CarnivalBen/golden-key/concept/circuit-board.JPG

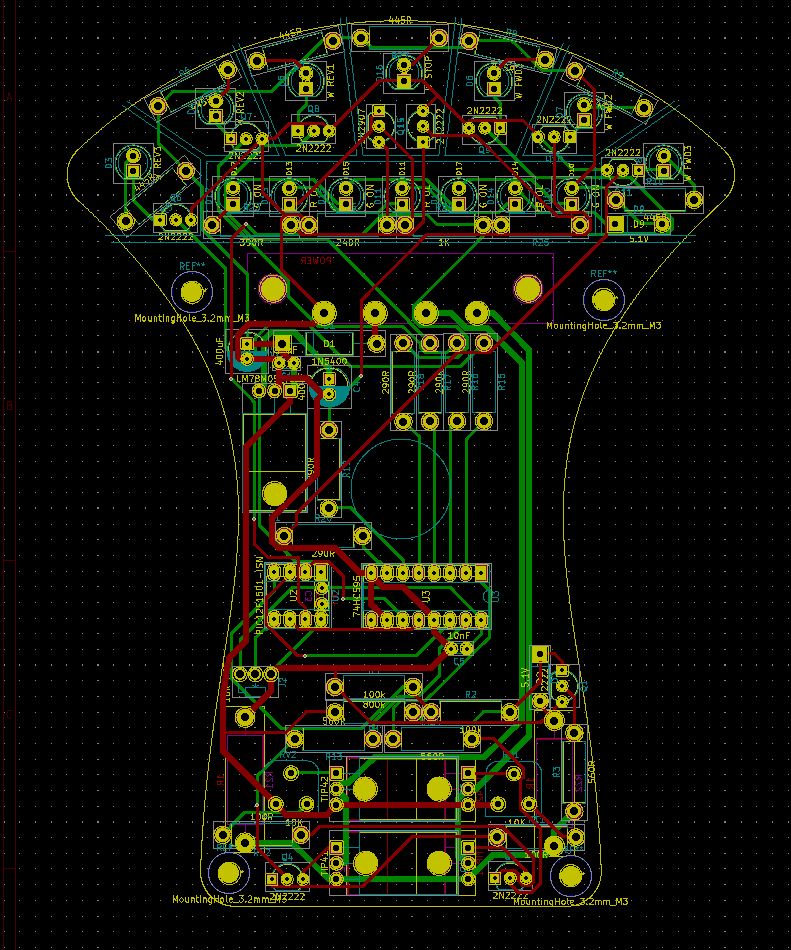
concept/circuit-board.JPG
