CarnivalBen/golden-key/concept/Golden Key Layout.JPG

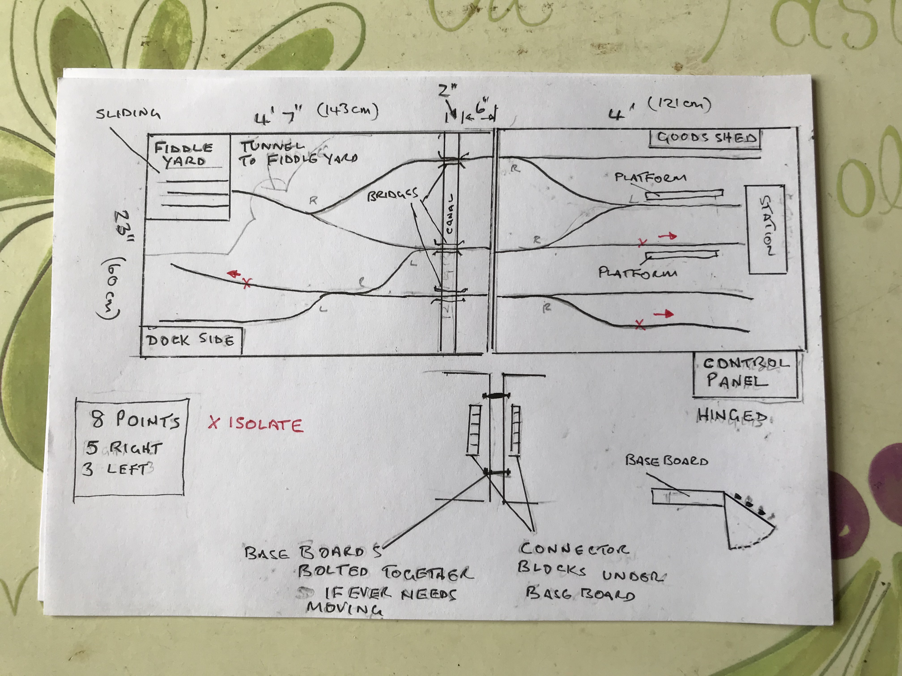
concept/Golden Key Layout.JPG
