CarnivalBen/golden-key/concept/Track Speed Adjust Graph 2.xlsx

Sheet: Sheet1
0 | 31 | 0x1F, | 8
1 | 31 | 0x1F,
2 | 31 | 0x1F,
3 | 31 | 0x1F,
4 | 31 | 0x1F,
5 | 31 | 0x1F,
6 | 31 | 0x1F,
7 | 31 | 0x1F,
8 | 30 | 0x1E,
9 | 30 | 0x1E,
10 | 30 | 0x1E,
11 | 30 | 0x1E,
12 | 30 | 0x1E,
13 | 30 | 0x1E,
14 | 30 | 0x1E,
15 | 30 | 0x1E,
16 | 29 | 0x1D,
17 | 29 | 0x1D,
18 | 29 | 0x1D,
19 | 29 | 0x1D,
20 | 29 | 0x1D,
21 | 29 | 0x1D,
22 | 29 | 0x1D,
23 | 29 | 0x1D,
24 | 28 | 0x1C,
25 | 28 | 0x1C,
26 | 28 | 0x1C,
27 | 28 | 0x1C,
28 | 28 | 0x1C,
29 | 28 | 0x1C,
30 | 28 | 0x1C,
31 | 28 | 0x1C,
32 | 27 | 0x1B,
33 | 27 | 0x1B,
34 | 27 | 0x1B,
35 | 27 | 0x1B,
36 | 27 | 0x1B,
37 | 27 | 0x1B,
38 | 27 | 0x1B,
39 | 27 | 0x1B,
40 | 26 | 0x1A,
41 | 26 | 0x1A,
42 | 26 | 0x1A,
43 | 26 | 0x1A,
44 | 26 | 0x1A,
45 | 26 | 0x1A,
46 | 26 | 0x1A,
47 | 26 | 0x1A,
48 | 25 | 0x19,
49 | 25 | 0x19,
50 | 25 | 0x19,
51 | 25 | 0x19,
52 | 25 | 0x19,
53 | 25 | 0x19,
54 | 25 | 0x19,
55 | 25 | 0x19,
56 | 24 | 0x18,
57 | 24 | 0x18,
58 | 24 | 0x18,
59 | 24 | 0x18,
60 | 24 | 0x18,
61 | 24 | 0x18,
62 | 24 | 0x18,
63 | 24 | 0x18,
64 | 23 | 0x17,
65 | 23 | 0x17,
66 | 23 | 0x17,
67 | 23 | 0x17,
68 | 23 | 0x17,
69 | 23 | 0x17,
70 | 23 | 0x17,
71 | 23 | 0x17,
72 | 22 | 0x16,
73 | 22 | 0x16,
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
