CarnivalBen/golden-key/concept/LED Count.xlsx

DK-1 | DK-1G | 4 | DK-1R | 4
MLE-1 | MLE-1G | 4 | MLE-1R | 4
MLE-2 | MLE-2G | 4 | MLE-2R | 3
SD-1 | SD-1G | 2 | SD-1R | 2
SD-2 | SD-2G | 2 | SD-2R | 3
FY-1 | FY-1G | 3 | FY-1R | 2
FY-2 | FY-2G | 3 | FY-2R | 2
FY-3 | FY-3G | 3 | FY-3R | 2
FY-4 | FY-4G | 3 | FY-4R | 2
FY-5 | FY-5G | 3 | FY-5R | 2 | 3 | 1 | 3 | 3
FY-6 | FY-6G | 2 | FY-6R | 2 | 2 | 0 | 2 | 0
LP-1 | LP-1G | 5 | LP-1R | 6 | 1 | 0 | 1 | 0
LP-2 | LP-2G | 1 | LP-2R | 2 | t | 0 | -1 | 0
LP-3 | LP-3G | 1 | LP-3R | 2 | d | 0 | -2 | 0
LP-4 | LP-4G | 3 | LP-4R | 2 |  | 1 |  | 3 | 0.406
LP-5 | LP-5G | 3 | LP-5R | 4
GS-1 | GS-1G | 4 | GS-1R | 4
PL1-1 | PL1-1G | 4 | PL1-1R | 3
PL2-1 | PL2-1G | 2 | PL2-1R | 2
PL2-2 | PL2-2G | 2 | PL2-2R | 2
MLW-1 | MLW-1G | 2 | MLW-1R | 2
MLW-2 | MLW-2G | 2 | MLW-2R | 2
MLW-3 | MLW-3G | 3 | MLW-3R | 3
MLW-4 | MLW-4G | 1 | MLW-4R | 1
 |  | 66 |  | 63
