CarnivalBen/golden-key/concept/Track Speed Adjust Graph.xlsx

Sheet: Sheet2
0 | 0 | 0x0, | 60 | 2 | 27.28
1 | 0.0620480731 | 0x0,
2 | 0.1251389466 | 0x0,
3 | 0.1892901462 | 0x0, |  | 255.1334871
4 | 0.254519492 | 0x0,
5 | 0.3208451038 | 0x0,
6 | 0.3882854057 | 0x0,
7 | 0.4568591316 | 0x0,
8 | 0.5265853302 | 0x1,
9 | 0.5974833703 | 0x1,
10 | 0.6695729464 | 0x1,
11 | 0.7428740836 | 0x1,
12 | 0.817407144 | 0x1,
13 | 0.8931928316 | 0x1,
14 | 0.9702521985 | 0x1,
15 | 1.048606651 | 0x1,
16 | 1.128277954 | 0x1,
17 | 1.209288239 | 0x1,
18 | 1.291660009 | 0x1,
19 | 1.375416147 | 0x1,
20 | 1.460579919 | 0x1,
21 | 1.54717498 | 0x2,
22 | 1.635225387 | 0x2,
23 | 1.724755599 | 0x2,
24 | 1.815790484 | 0x2,
25 | 1.908355332 | 0x2,
26 | 2.002475855 | 0x2,
27 | 2.098178199 | 0x2,
28 | 2.195488948 | 0x2,
29 | 2.294435134 | 0x2,
30 | 2.395044242 | 0x2,
31 | 2.49734422 | 0x2,
32 | 2.601363485 | 0x3,
33 | 2.707130933 | 0x3,
34 | 2.814675942 | 0x3,
35 | 2.924028389 | 0x3,
36 | 3.03521865 | 0x3,
37 | 3.14827761 | 0x3,
38 | 3.263236677 | 0x3,
39 | 3.380127784 | 0x3,
40 | 3.498983401 | 0x3,
41 | 3.619836545 | 0x4,
42 | 3.742720787 | 0x4,
43 | 3.867670262 | 0x4,
44 | 3.99471968 | 0x4,
45 | 4.123904332 | 0x4,
46 | 4.255260103 | 0x4,
47 | 4.388823484 | 0x4,
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
