CarnivalBen/golden-key/concept/Book1.xlsx

Sheet: Layout
 | 0 | 1 | 2 | 3 | 4 | 5 | 6 | 7 | 8 | 9 | 10 | 11 | 12 | 13 | 14 | 15 | 16 | 17 | 18 | 19 | 20 | 21 | 22 | 23 | 24 | 25 | 26 | 27 | 28 | 29 | 30 | 31 | 32 | 33 | 34 | 35 | 36 | 37 | 38 | 39 | 40 | 41 | 42 | 43 | 44 | 45 | 46 | 47 | 48 | 49 | 50 | 51 | 52 | 53 | 54 | 55 | 56 | 57 | 58
0
1 |  |  |  |  |  |  |  |  |  |  |  |  |  |  | b | s | s | s | s | s | s | s | p | p | p | x | x | x | x | x | x | x | x | x
2 |  |  |  |  |  |  |  |  |  |  |  |  |  | b |  |  |  |  |  |  |  |  |  | p
3 |  |  |  |  |  |  |  |  |  |  |  |  | yb |  |  |  |  |  |  |  |  |  |  |  | py
4 |  |  |  |  |  |  |  |  |  |  |  | y |  |  |  |  |  |  |  |  |  |  |  |  |  | y
5 |  | s | s | s | s | s | i | s | s | s | y |  |  |  |  |  |  |  |  |  |  |  |  |  |  |  | y | x | x | x | x | x | x | x
6 |  |  |  |  |  |  |  |  |  |  |  | y |  |  |  |  |  |  |  |  |  |  |  |  |  | y
7 |  |  |  |  |  |  |  |  |  |  |  |  | yb |  |  |  |  |  |  |  |  |  |  |  | py
8 |  |  |  |  |  |  |  |  |  |  |  |  |  | b |  |  |  |  |  |  |  |  |  | p
9 |  |  |  |  |  |  |  |  |  |  |  |  |  |  | b | p | p | p | s | s | s | s | p | p | p | x | x | x | i | x | x | x | x | x
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
