CarnivalBen/golden-key/concept/Controller-Render.JPG

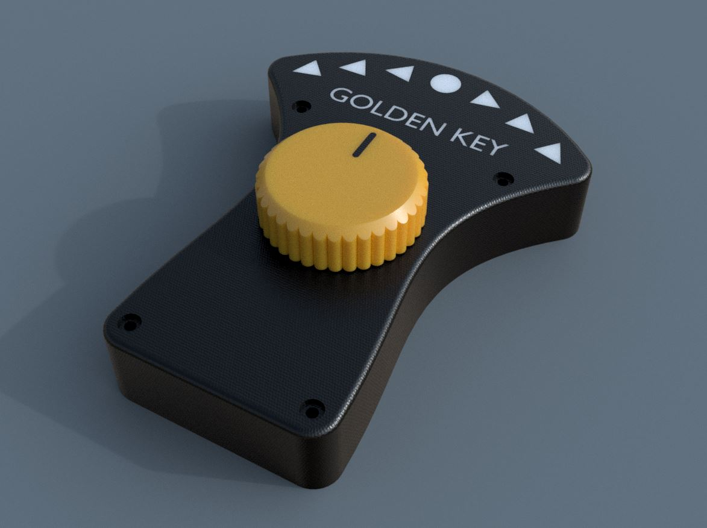
concept/Controller-Render.JPG
