CarnivalBen/golden-key/concept/PWM-DIR-Gates.JPG

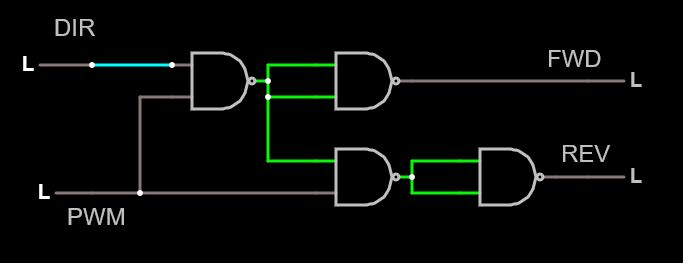
concept/PWM-DIR-Gates.JPG
