CarnivalBen/golden-key/stl/controller-main-body.stl

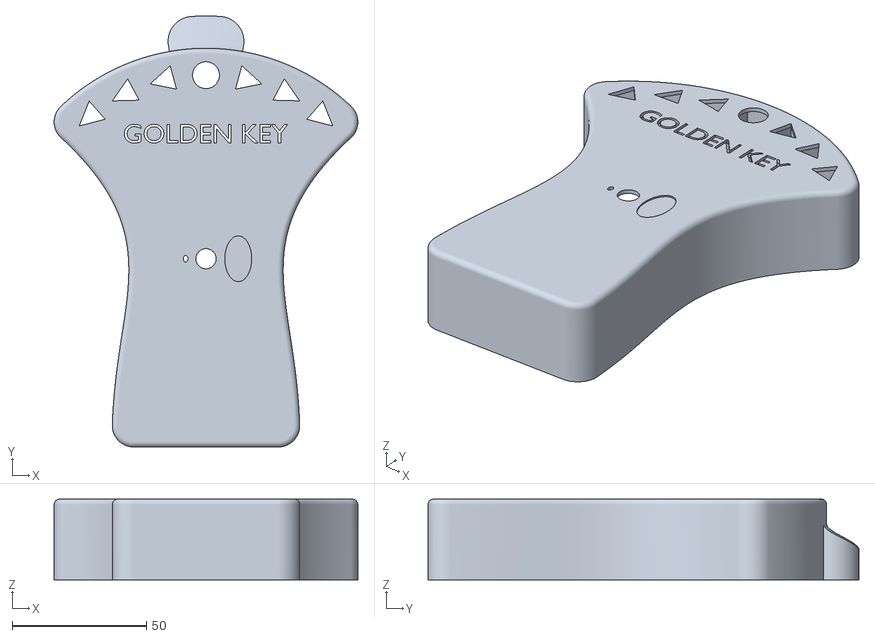
[picture p14: CAD file, 2020-08-21]
stl/controller-main-body.stl
112.9 x 160.3 x 30.0
