CarnivalBen/golden-key/concept/missed leds.dxf

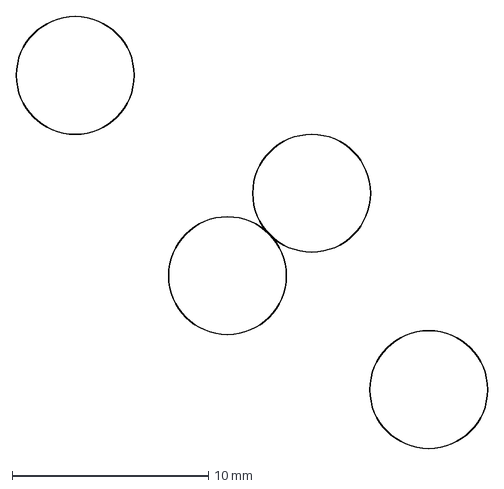
[picture p15: CAD file, 2020-06-27]
concept/missed leds.dxf
24.0 x 22.0 mm
