CarnivalBen/golden-key/stl/spacer.stl

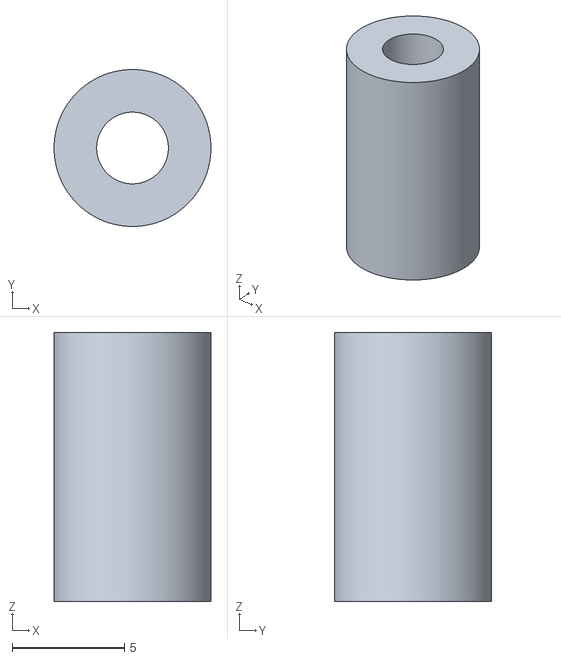
[picture p16: CAD file, 2020-08-28]
stl/spacer.stl
7.00 x 7.00 x 12.0
