CarnivalBen/golden-key/concept/PCB Outline.dxf

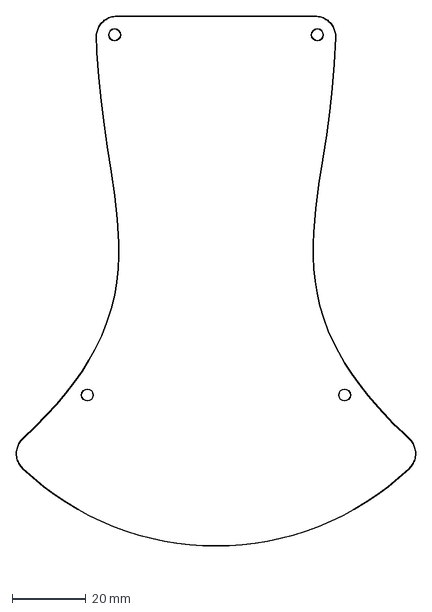
[picture p17: CAD file, 2020-06-27]
concept/PCB Outline.dxf
108.2 x 150.4 mm
