CarnivalBen/golden-key/stl/cable-tie-18.stl

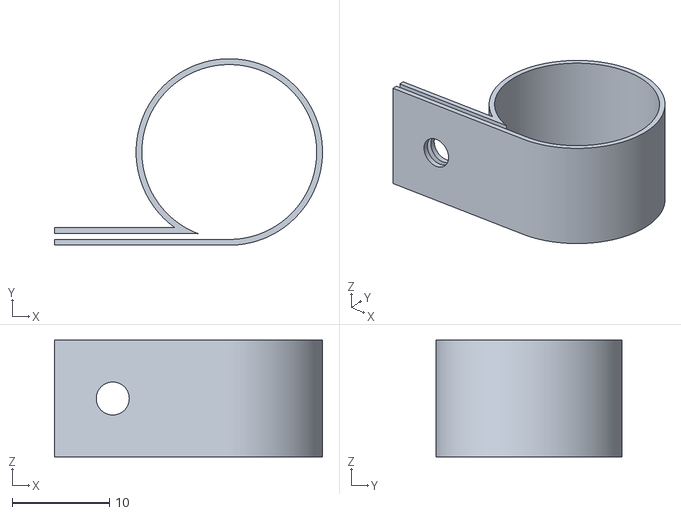
[picture p18: CAD file, 2020-08-28]
stl/cable-tie-18.stl
27.6 x 19.2 x 12.0
