CarnivalBen/golden-key/concept/dial.stl

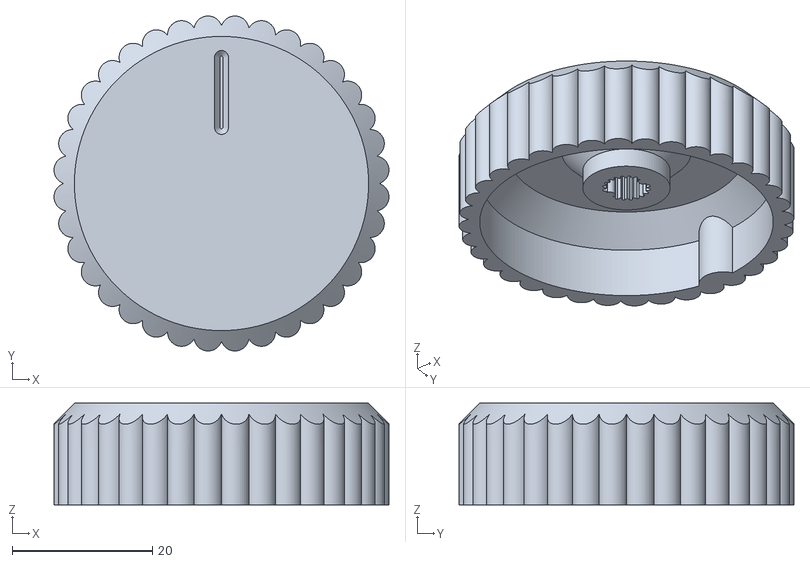
[picture p19: CAD file, 2020-06-27]
concept/dial.stl
47.8 x 47.8 x 14.5
