CarnivalBen/golden-key/stl/test-panel.stl

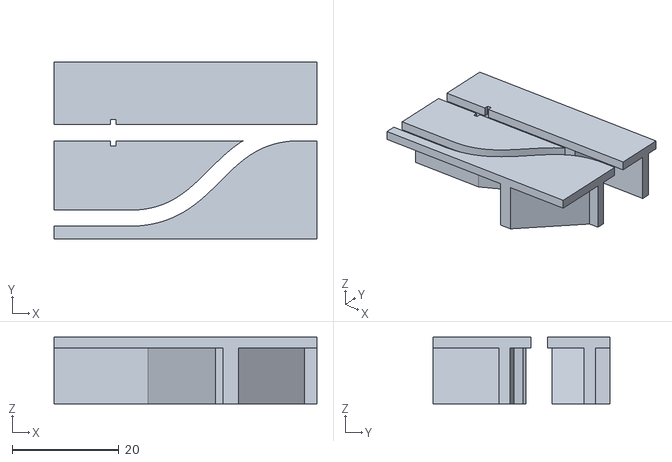
[picture p20: CAD file, 2020-08-28]
stl/test-panel.stl
49.2 x 33.2 x 12.5
