CarnivalBen/golden-key/concept/dial-pointer.stl

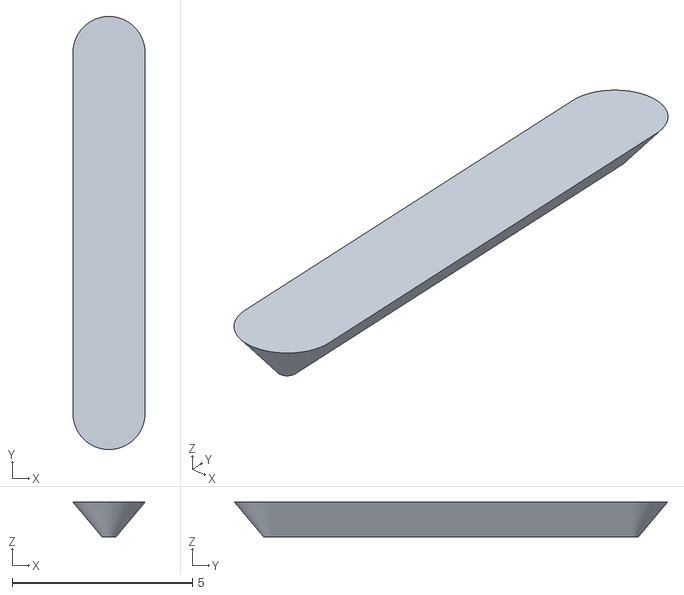
[picture p21: CAD file, 2020-06-27]
concept/dial-pointer.stl
2.00 x 12.0 x 0.96
