CarnivalBen/golden-key/stl/cable-tie-20.stl

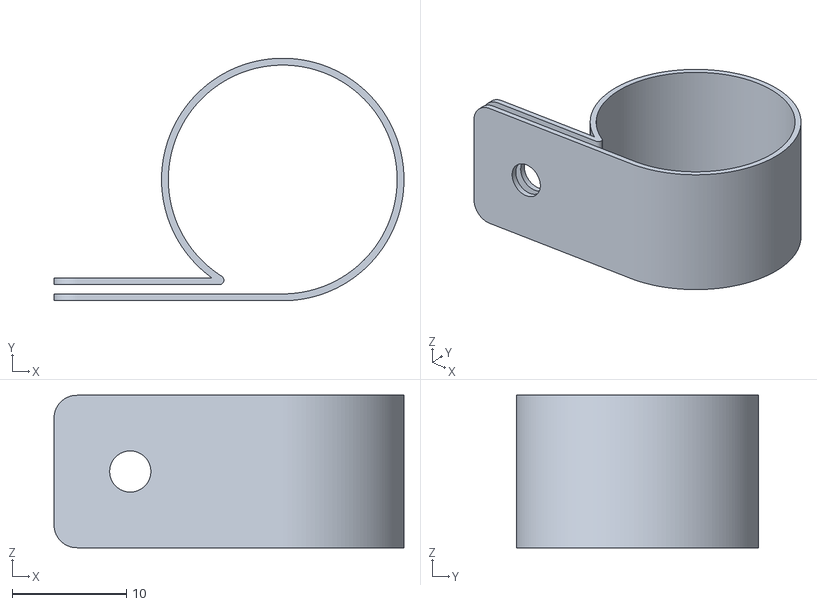
[picture p22: CAD file, 2020-08-28]
stl/cable-tie-20.stl
30.6 x 21.2 x 13.3
