CarnivalBen/golden-key/concept/Display Board PCB Export.dxf

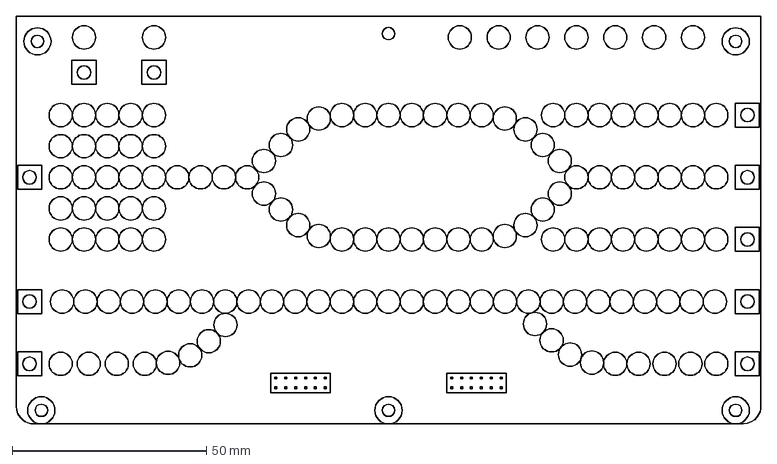
[picture p23: CAD file, 2020-06-27]
concept/Display Board PCB Export.dxf
191.7 x 104.9 mm
