CarnivalBen/golden-key/stl/test-inset.stl

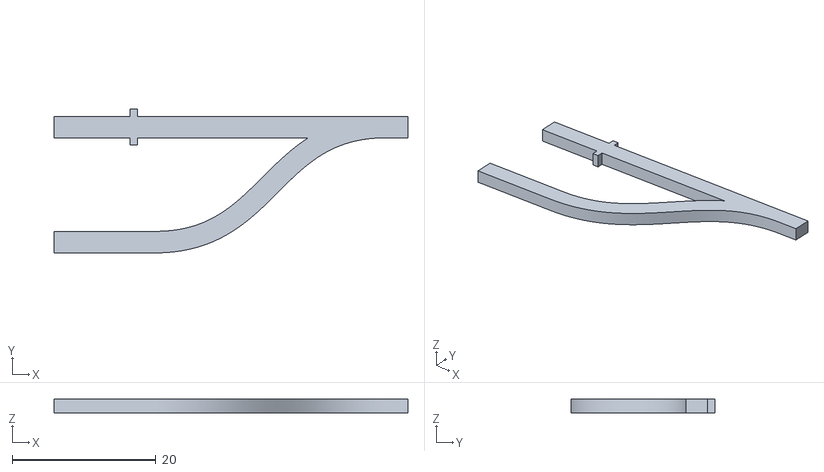
[picture p24: CAD file, 2020-08-28]
stl/test-inset.stl
49.2 x 20.0 x 2.00
