CarnivalBen/golden-key/concept/track layout.dxf

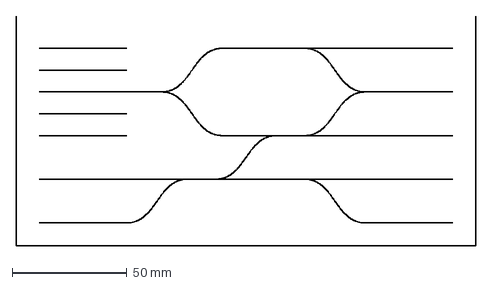
[picture p25: CAD file, 2020-06-27]
concept/track layout.dxf
200.0 x 100.0 mm
