CarnivalBen/golden-key/stl/cable-tie.stl

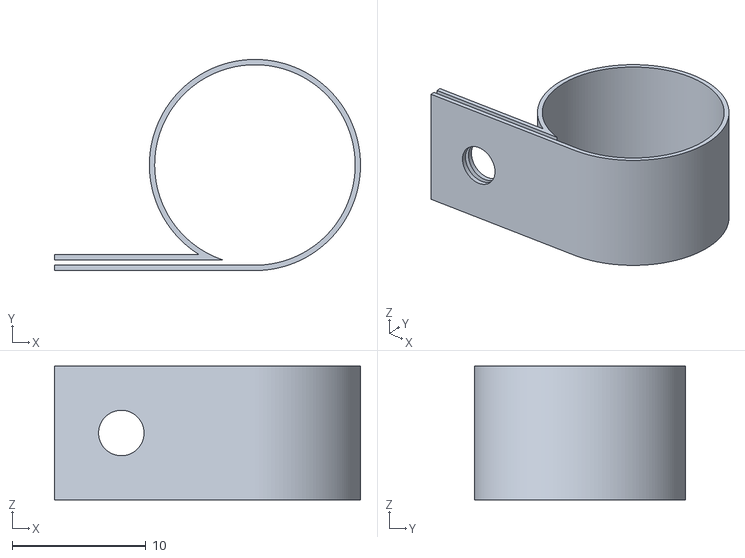
[picture p26: CAD file, 2020-08-28]
stl/cable-tie.stl
22.9 x 15.8 x 10.0
