CarnivalBen/golden-key/concept/PCB Layout.dxf

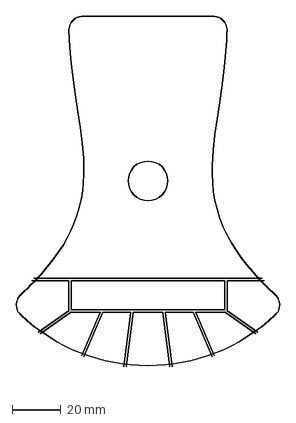
[picture p27: CAD file, 2020-06-27]
concept/PCB Layout.dxf
108.2 x 150.4 mm
