CarnivalBen/golden-key/stl/panel-base.stl

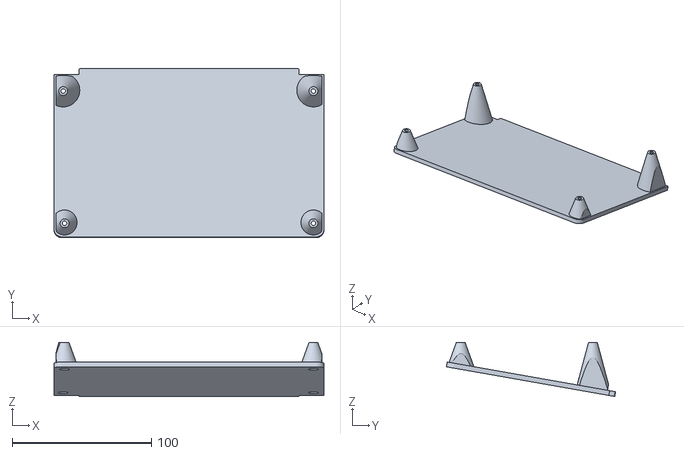
[picture p28: CAD file, 2020-08-28]
stl/panel-base.stl
193.9 x 121.6 x 38.8
