CarnivalBen/golden-key/stl/TO-220-pad.stl

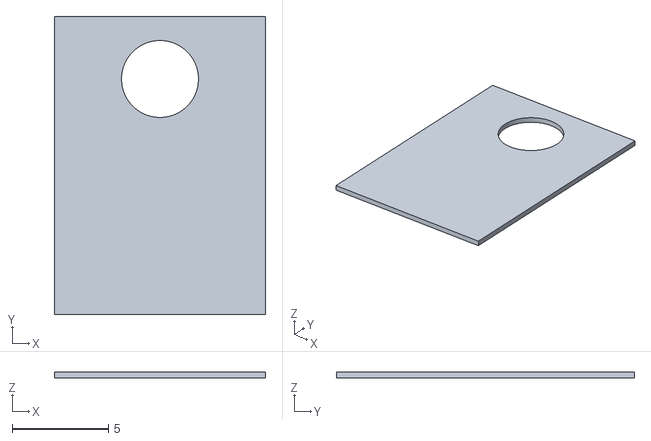
[picture p29: CAD file, 2020-08-28]
stl/TO-220-pad.stl
11.0 x 15.5 x 0.32
