CarnivalBen/golden-key/stl/sensor-mount.stl

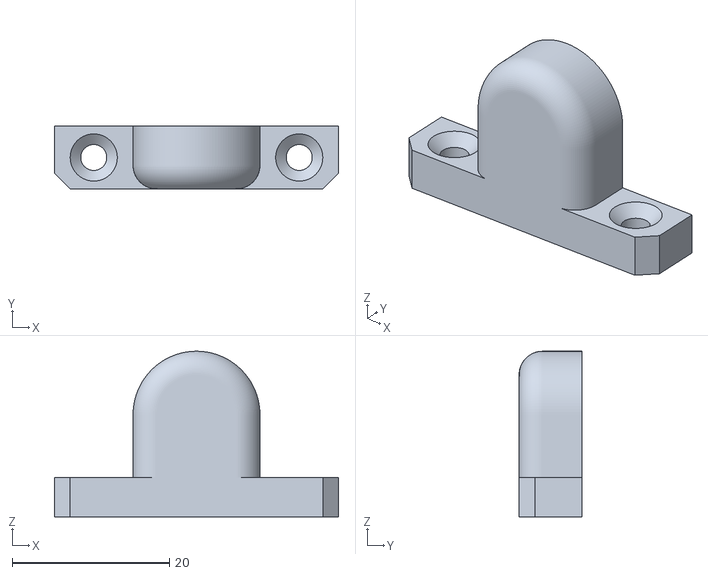
[picture p30: CAD file, 2020-08-28]
stl/sensor-mount.stl
36.2 x 8.00 x 21.1
