CarnivalBen/golden-key/stl/button.stl

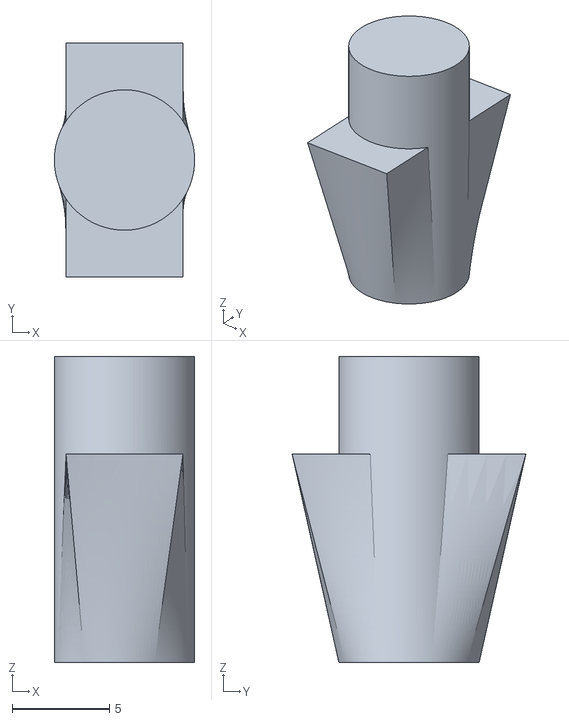
[picture p31: CAD file, 2020-08-28]
stl/button.stl
7.20 x 12.0 x 15.7
