CarnivalBen/golden-key/stl/panel-case.stl

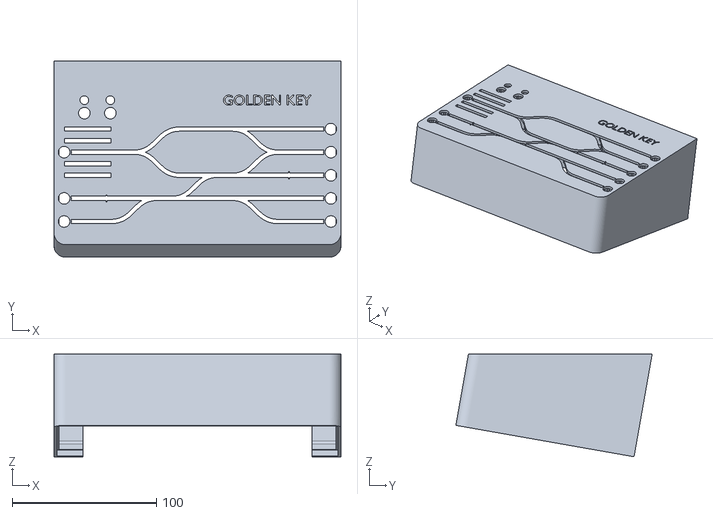
[picture p32: CAD file, 2020-08-21]
stl/panel-case.stl
198.7 x 135.9 x 71.0
