CarnivalBen/golden-key/stl/controller-middler-testpiece.stl

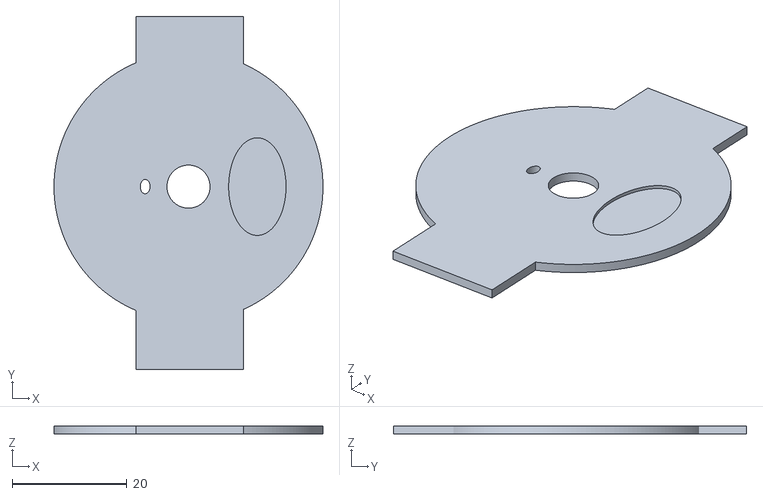
[picture p33: CAD file, 2020-08-21]
stl/controller-middler-testpiece.stl
46.9 x 61.6 x 1.40
