CarnivalBen/golden-key/stl/controller-thick-middler.stl

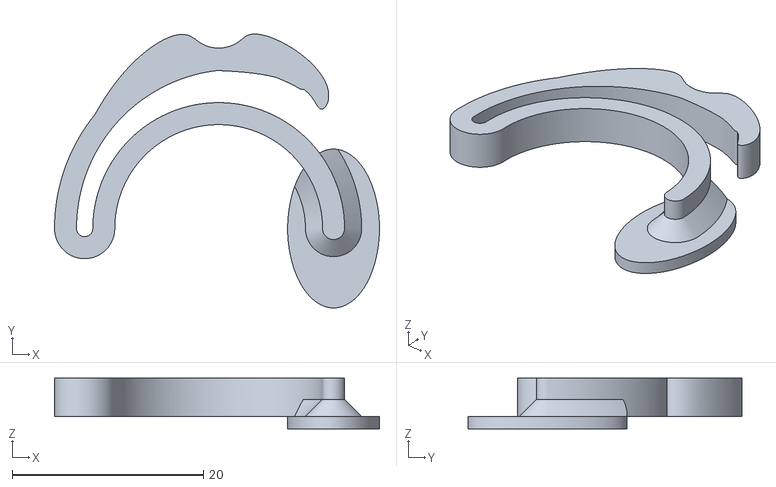
[picture p34: CAD file, 2020-08-21]
stl/controller-thick-middler.stl
33.9 x 28.6 x 5.30
