CarnivalBen/golden-key/stl/panel-inset.stl

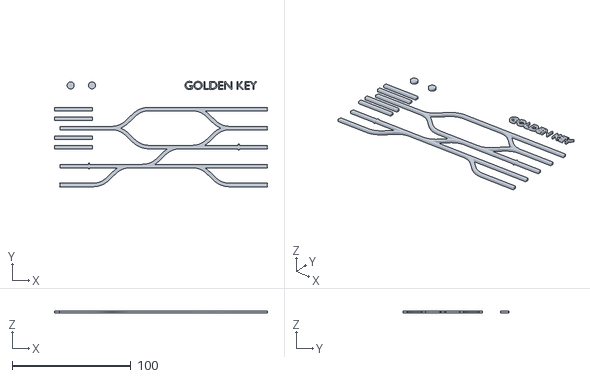
[picture p35: CAD file, 2020-08-21]
stl/panel-inset.stl
179.6 x 89.0 x 2.00
