CarnivalBen/golden-key/stl/magnet-mount.stl

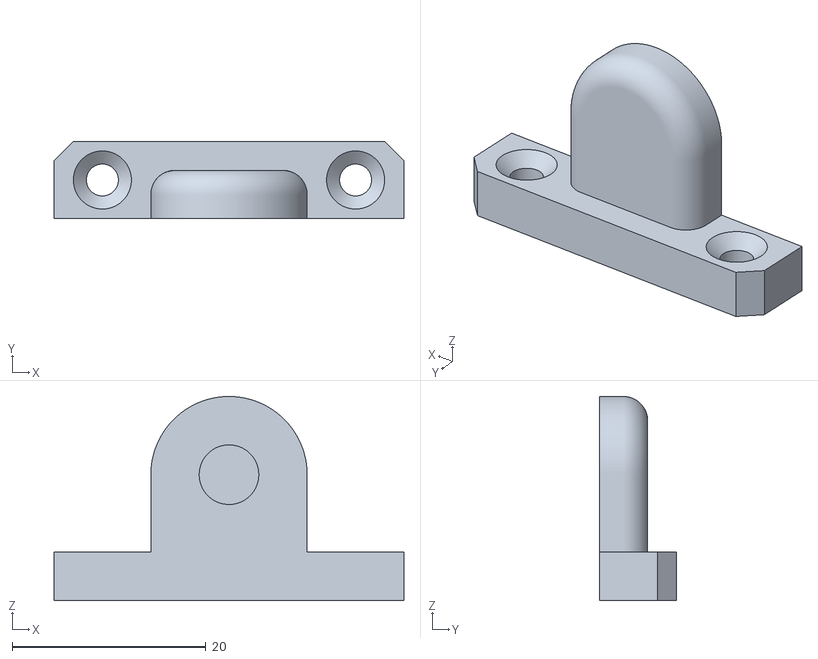
[picture p36: CAD file, 2020-08-21]
stl/magnet-mount.stl
36.2 x 8.00 x 21.1
