CarnivalBen/golden-key/stl/controller-windows.stl

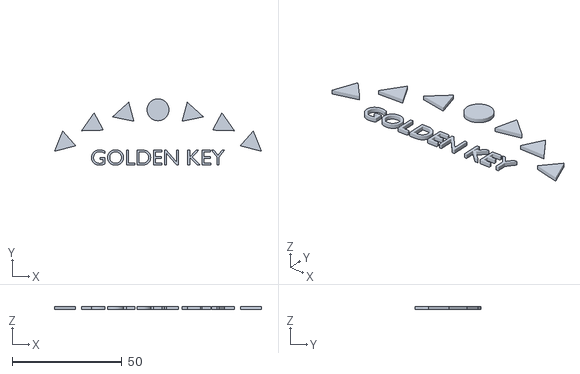
[picture p37: CAD file, 2020-08-21]
stl/controller-windows.stl
94.3 x 30.2 x 1.40
