CarnivalBen/golden-key/stl/controller-lid.stl

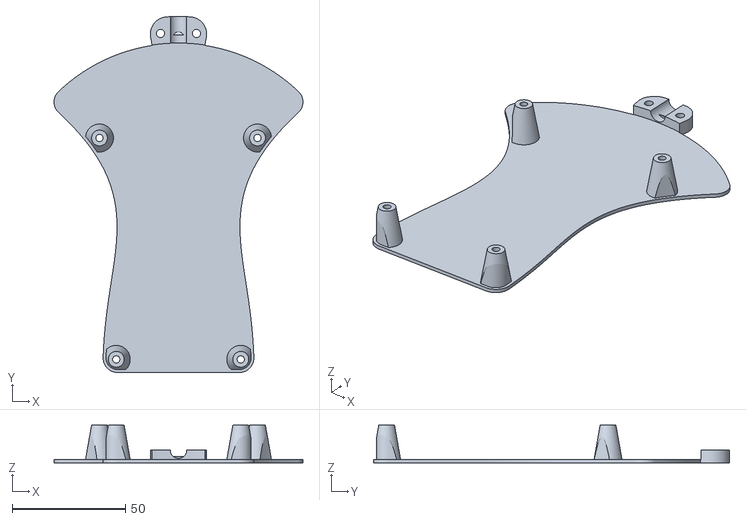
[picture p38: CAD file, 2020-08-21]
stl/controller-lid.stl
109.7 x 157.0 x 16.6
