CarnivalBen/golden-key/stl/controller-middler.stl

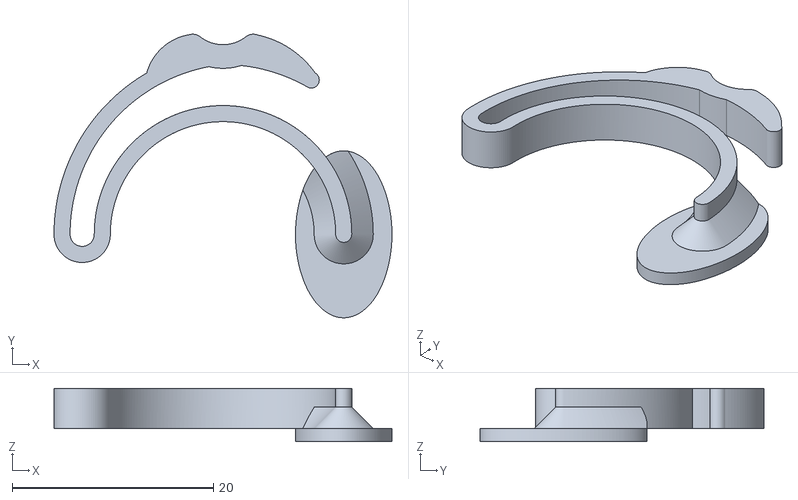
[picture p39: CAD file, 2020-08-21]
stl/controller-middler.stl
33.6 x 28.2 x 5.30
