CarnivalBen/golden-key/Layout Panel Drawing v1.pdf

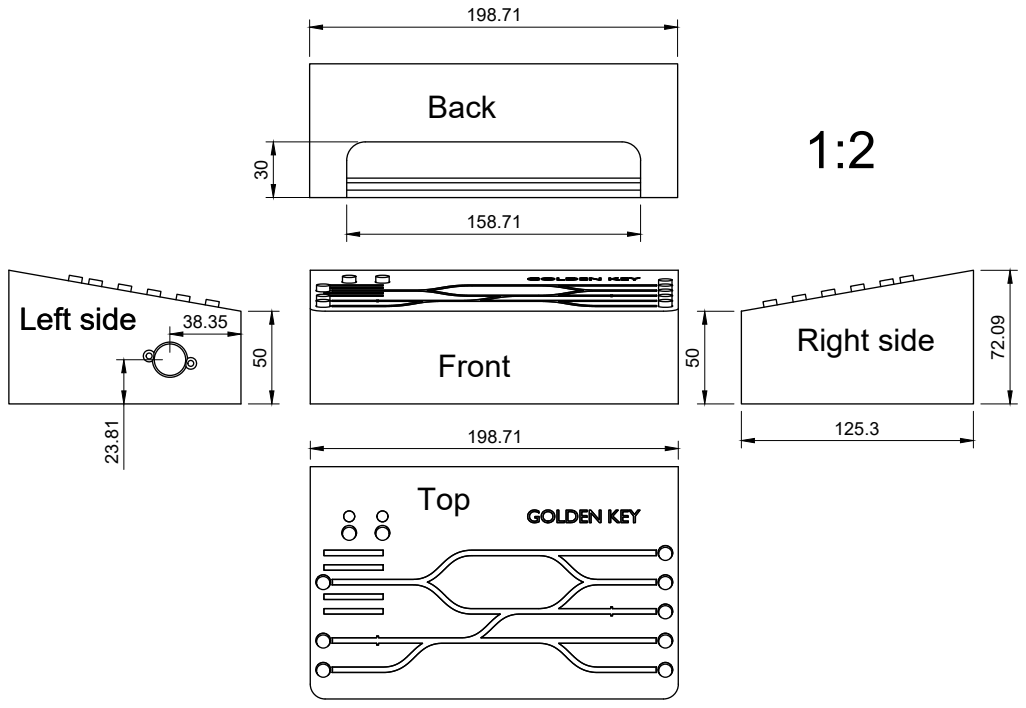
[picture p40: page 1]
Left side; Right side

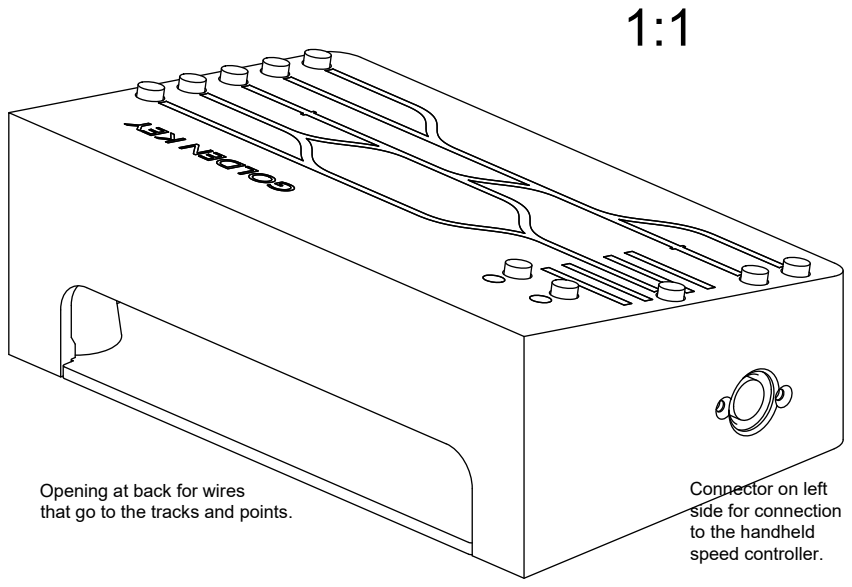
[picture p41: page 2]

Connector on left
side for connection
to the handheld
speed controller.

Opening at back for wires
that go to the tracks and points.

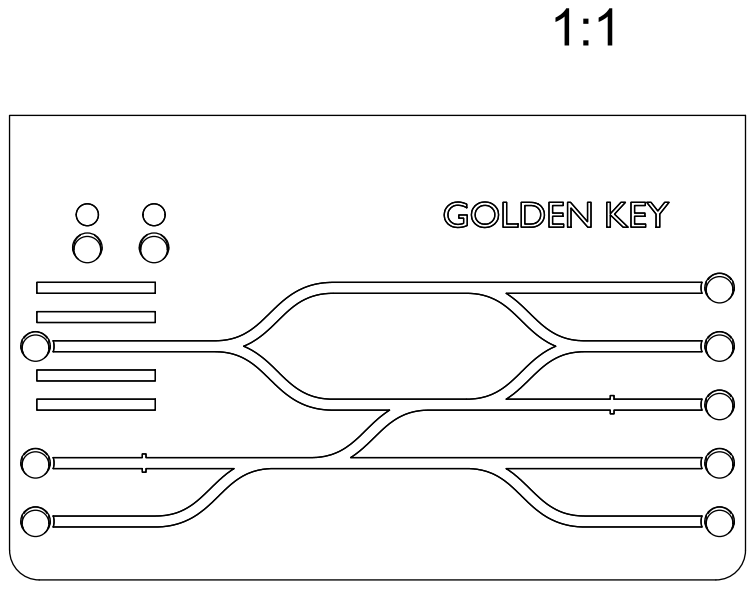
[picture p42: page 3]
