CarnivalBen/golden-key/layout-diag/layout.pdf

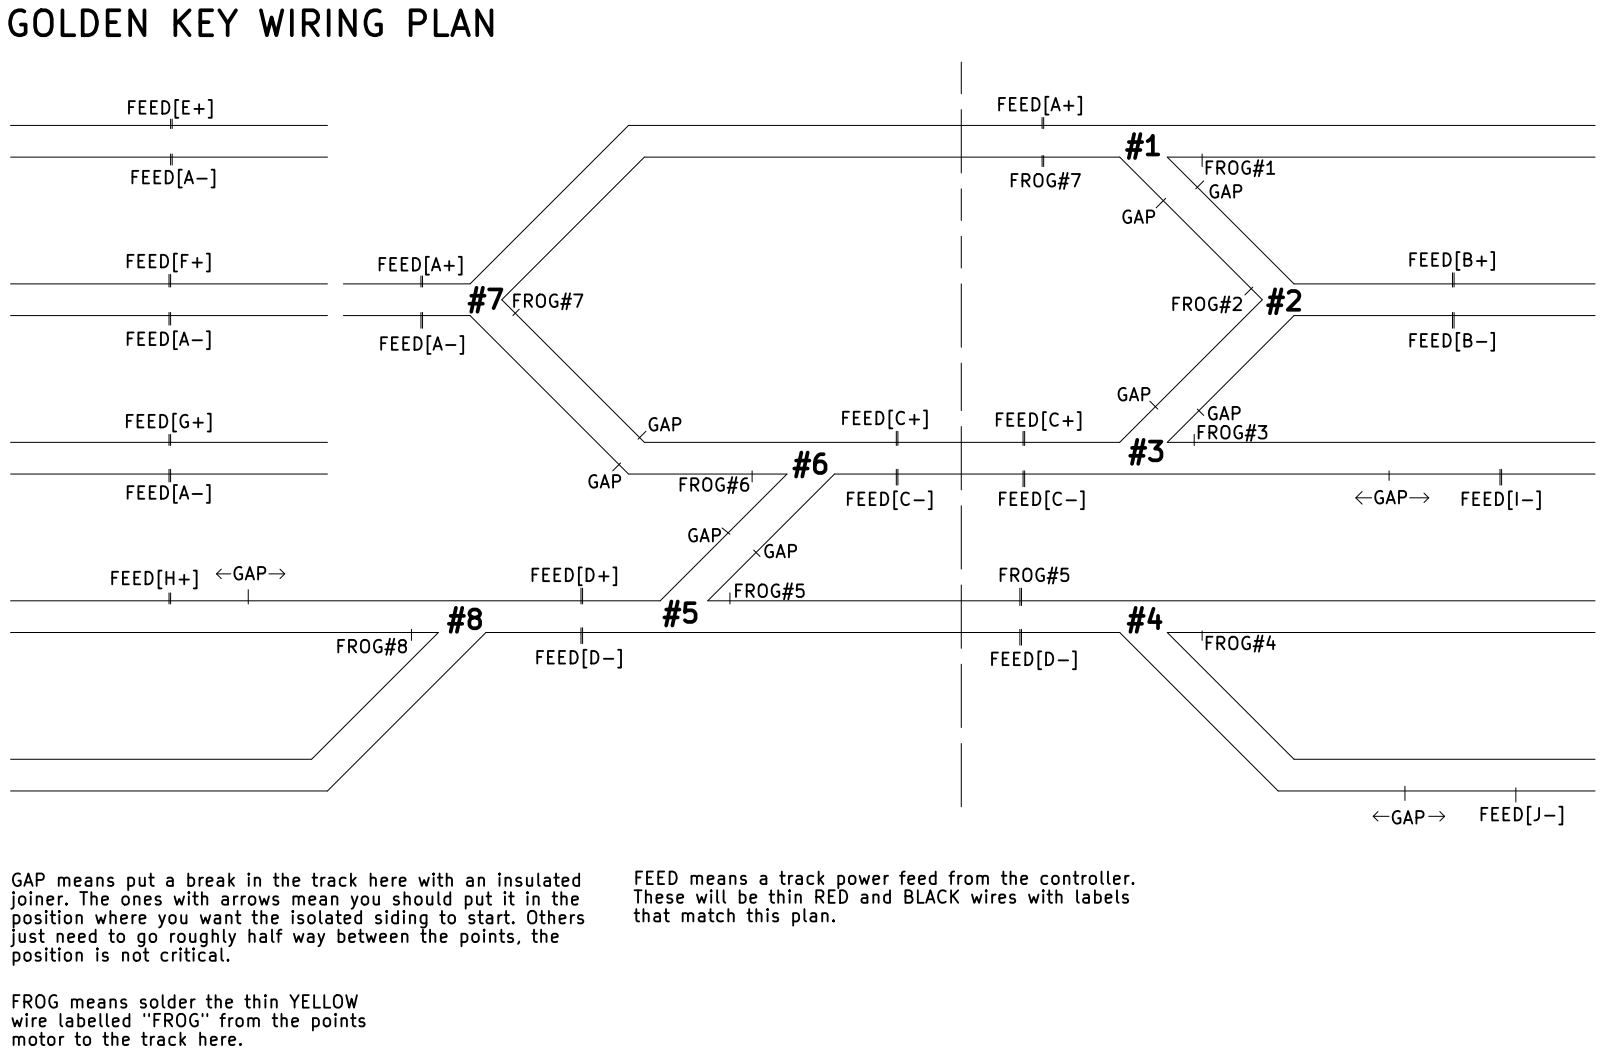
[picture p43: page 1]
