CarnivalBen/golden-key/panel/pcb-display/panel-display.kicad_pcb

## KiCad design panel/pcb-display/panel-display.kicad_pcb (2020-08-28)

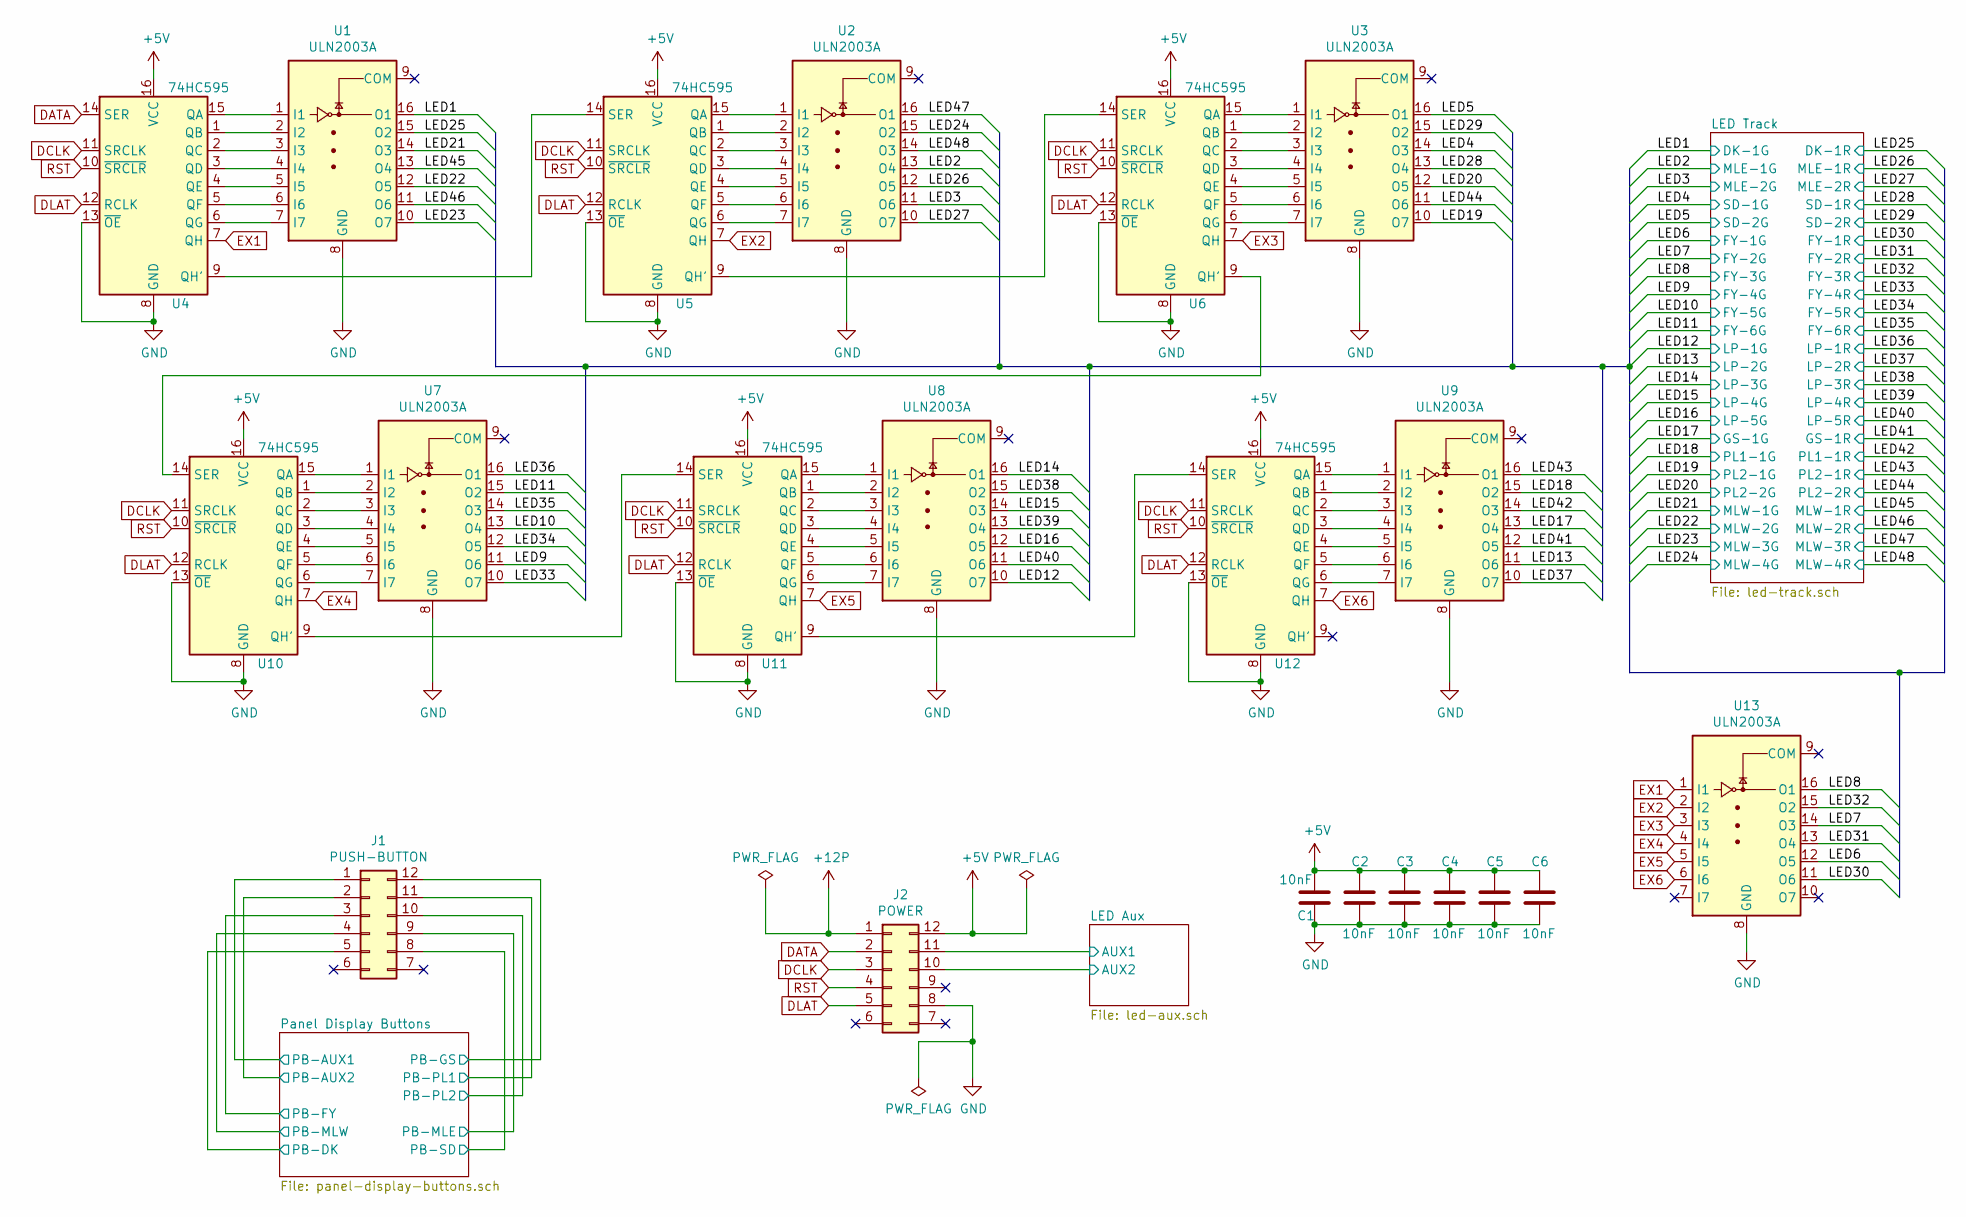
[picture p44: schematic panel-display.sch]

Parts:
C1, C2, C3, C4, C5, C6: 10nF; C_Disc_D3.0mm_W1.6mm_P2.50mm
J1: PUSH-BUTTON; Pin_Header_Straight_2x06_Pitch2.54mm
J2: POWER; Pin_Header_Straight_2x06_Pitch2.54mm
U1, U2, U3, U7, U8, U9, U13: ULN2003A; DIP-16_W7.62mm_LongPads
U4, U5, U6, U10, U11, U12: 74HC595; DIP-16_W7.62mm_LongPads

Connections:
+5V: C1.2, C2.2, C3.2, C4.2, C5.2, C6.2, J2.12, U4.16 (VCC), U5.16 (VCC), U6.16 (VCC), U10.16 (VCC), U11.16 (VCC), U12.16 (VCC); also elsewhere on the board
+12P: J2.1; also elsewhere on the board
/LED1: U1.16 (O1); also elsewhere on the board
/LED2: U2.13 (O4); also elsewhere on the board
/LED3: U2.11 (O6); also elsewhere on the board
/LED4: U3.14 (O3); also elsewhere on the board
/LED5: U3.16 (O1); also elsewhere on the board
/LED6: U13.12 (O5); also elsewhere on the board
/LED7: U13.14 (O3); also elsewhere on the board
/LED8: U13.16 (O1); also elsewhere on the board
/LED9: U7.11 (O6); also elsewhere on the board
/LED10: U7.13 (O4); also elsewhere on the board
/LED11: U7.15 (O2); also elsewhere on the board
/LED12: U8.10 (O7); also elsewhere on the board
/LED13: U9.11 (O6); also elsewhere on the board
/LED14: U8.16 (O1); also elsewhere on the board
/LED15: U8.14 (O3); also elsewhere on the board
/LED16: U8.12 (O5); also elsewhere on the board
/LED17: U9.13 (O4); also elsewhere on the board
/LED18: U9.15 (O2); also elsewhere on the board
/LED19: U3.10 (O7); also elsewhere on the board
/LED20: U3.12 (O5); also elsewhere on the board
/LED21: U1.14 (O3); also elsewhere on the board
/LED22: U1.12 (O5); also elsewhere on the board
/LED23: U1.10 (O7); also elsewhere on the board
/LED24: U2.15 (O2); also elsewhere on the board
/LED25: U1.15 (O2); also elsewhere on the board
/LED26: U2.12 (O5); also elsewhere on the board
/LED27: U2.10 (O7); also elsewhere on the board
/LED28: U3.13 (O4); also elsewhere on the board
/LED29: U3.15 (O2); also elsewhere on the board
/LED30: U13.11 (O6); also elsewhere on the board
/LED31: U13.13 (O4); also elsewhere on the board
/LED32: U13.15 (O2); also elsewhere on the board
/LED33: U7.10 (O7); also elsewhere on the board
/LED34: U7.12 (O5); also elsewhere on the board
/LED35: U7.14 (O3); also elsewhere on the board
/LED36: U7.16 (O1); also elsewhere on the board
/LED37: U9.10 (O7); also elsewhere on the board
/LED38: U8.15 (O2); also elsewhere on the board
/LED39: U8.13 (O4); also elsewhere on the board
/LED40: U8.11 (O6); also elsewhere on the board
/LED41: U9.12 (O5); also elsewhere on the board
/LED42: U9.14 (O3); also elsewhere on the board
/LED43: U9.16 (O1); also elsewhere on the board
/LED44: U3.11 (O6); also elsewhere on the board
/LED45: U1.13 (O4); also elsewhere on the board
/LED46: U1.11 (O6); also elsewhere on the board
/LED47: U2.16 (O1); also elsewhere on the board
/LED48: U2.14 (O3); also elsewhere on the board
/LED Aux/AUX1: J2.11; also elsewhere on the board
/LED Aux/AUX2: J2.10; also elsewhere on the board
/Panel Display Buttons/PB-AUX1: J1.1; also elsewhere on the board
/Panel Display Buttons/PB-AUX2: J1.2; also elsewhere on the board
/Panel Display Buttons/PB-DK: J1.5; also elsewhere on the board
/Panel Display Buttons/PB-FY: J1.3; also elsewhere on the board
/Panel Display Buttons/PB-GS: J1.12; also elsewhere on the board
/Panel Display Buttons/PB-MLE: J1.9; also elsewhere on the board
/Panel Display Buttons/PB-MLW: J1.4; also elsewhere on the board
/Panel Display Buttons/PB-PL1: J1.11; also elsewhere on the board
/Panel Display Buttons/PB-PL2: J1.10; also elsewhere on the board
/Panel Display Buttons/PB-SD: J1.8; also elsewhere on the board
DATA: J2.2, U4.14 (SER)
DCLK: J2.3, U4.11 (SRCLK), U5.11 (SRCLK), U6.11 (SRCLK), U10.11 (SRCLK), U11.11 (SRCLK), U12.11 (SRCLK)
DLAT: J2.5, U4.12 (RCLK), U5.12 (RCLK), U6.12 (RCLK), U10.12 (RCLK), U11.12 (RCLK), U12.12 (RCLK)
EX1: U4.7 (QH), U13.1 (I1)
EX2: U5.7 (QH), U13.2 (I2)
EX3: U6.7 (QH), U13.3 (I3)
EX4: U10.7 (QH), U13.4 (I4)
EX5: U11.7 (QH), U13.5 (I5)
EX6: U12.7 (QH), U13.6 (I6)
GND: C1.1, C2.1, C3.1, C4.1, C5.1, C6.1, J2.8, U1.8 (GND), U2.8 (GND), U3.8 (GND), U4.8 (GND), U4.13 (~OE), U5.8 (GND), U5.13 (~OE), U6.8 (GND), U6.13 (~OE), U7.8 (GND), U8.8 (GND), U9.8 (GND), U10.8 (GND), U10.13 (~OE), U11.8 (GND), U11.13 (~OE), U12.8 (GND), U12.13 (~OE), U13.8 (GND); also elsewhere on the board
unnamed: U1.1 (I1), U4.15 (QA)
unnamed: U1.2 (I2), U4.1 (QB)
unnamed: U1.3 (I3), U4.2 (QC)
unnamed: U1.4 (I4), U4.3 (QD)
unnamed: U1.5 (I5), U4.4 (QE)
unnamed: U1.6 (I6), U4.5 (QF)
unnamed: U1.7 (I7), U4.6 (QG)
unnamed: U2.1 (I1), U5.15 (QA)
unnamed: U2.2 (I2), U5.1 (QB)
unnamed: U2.3 (I3), U5.2 (QC)
unnamed: U2.4 (I4), U5.3 (QD)
unnamed: U2.5 (I5), U5.4 (QE)
unnamed: U2.6 (I6), U5.5 (QF)
unnamed: U2.7 (I7), U5.6 (QG)
unnamed: U3.1 (I1), U6.15 (QA)
unnamed: U3.2 (I2), U6.1 (QB)
unnamed: U3.3 (I3), U6.2 (QC)
unnamed: U3.4 (I4), U6.3 (QD)
unnamed: U3.5 (I5), U6.4 (QE)
unnamed: U3.6 (I6), U6.5 (QF)
unnamed: U3.7 (I7), U6.6 (QG)
unnamed: U4.9 (QH'), U5.14 (SER)
unnamed: U5.9 (QH'), U6.14 (SER)
unnamed: U7.2 (I2), U10.1 (QB)
unnamed: U7.3 (I3), U10.2 (QC)
unnamed: U7.4 (I4), U10.3 (QD)
unnamed: U7.5 (I5), U10.4 (QE)
unnamed: U7.6 (I6), U10.5 (QF)
unnamed: U7.7 (I7), U10.6 (QG)
unnamed: U10.9 (QH'), U11.14 (SER)
unnamed: U6.9 (QH'), U10.14 (SER)
unnamed: U7.1 (I1), U10.15 (QA)
unnamed: U8.2 (I2), U11.1 (QB)
unnamed: U8.3 (I3), U11.2 (QC)
unnamed: U8.4 (I4), U11.3 (QD)
unnamed: U8.5 (I5), U11.4 (QE)
unnamed: U8.6 (I6), U11.5 (QF)
unnamed: U8.7 (I7), U11.6 (QG)
unnamed: U11.9 (QH'), U12.14 (SER)
unnamed: U8.1 (I1), U11.15 (QA)
unnamed: U9.2 (I2), U12.1 (QB)
unnamed: U9.3 (I3), U12.2 (QC)
unnamed: U9.4 (I4), U12.3 (QD)
unnamed: U9.5 (I5), U12.4 (QE)
unnamed: U9.6 (I6), U12.5 (QF)
unnamed: U9.7 (I7), U12.6 (QG)
unnamed: U9.1 (I1), U12.15 (QA)
RST: J2.4, U4.10 (~SRCLR), U5.10 (~SRCLR), U6.10 (~SRCLR), U10.10 (~SRCLR), U11.10 (~SRCLR), U12.10 (~SRCLR)

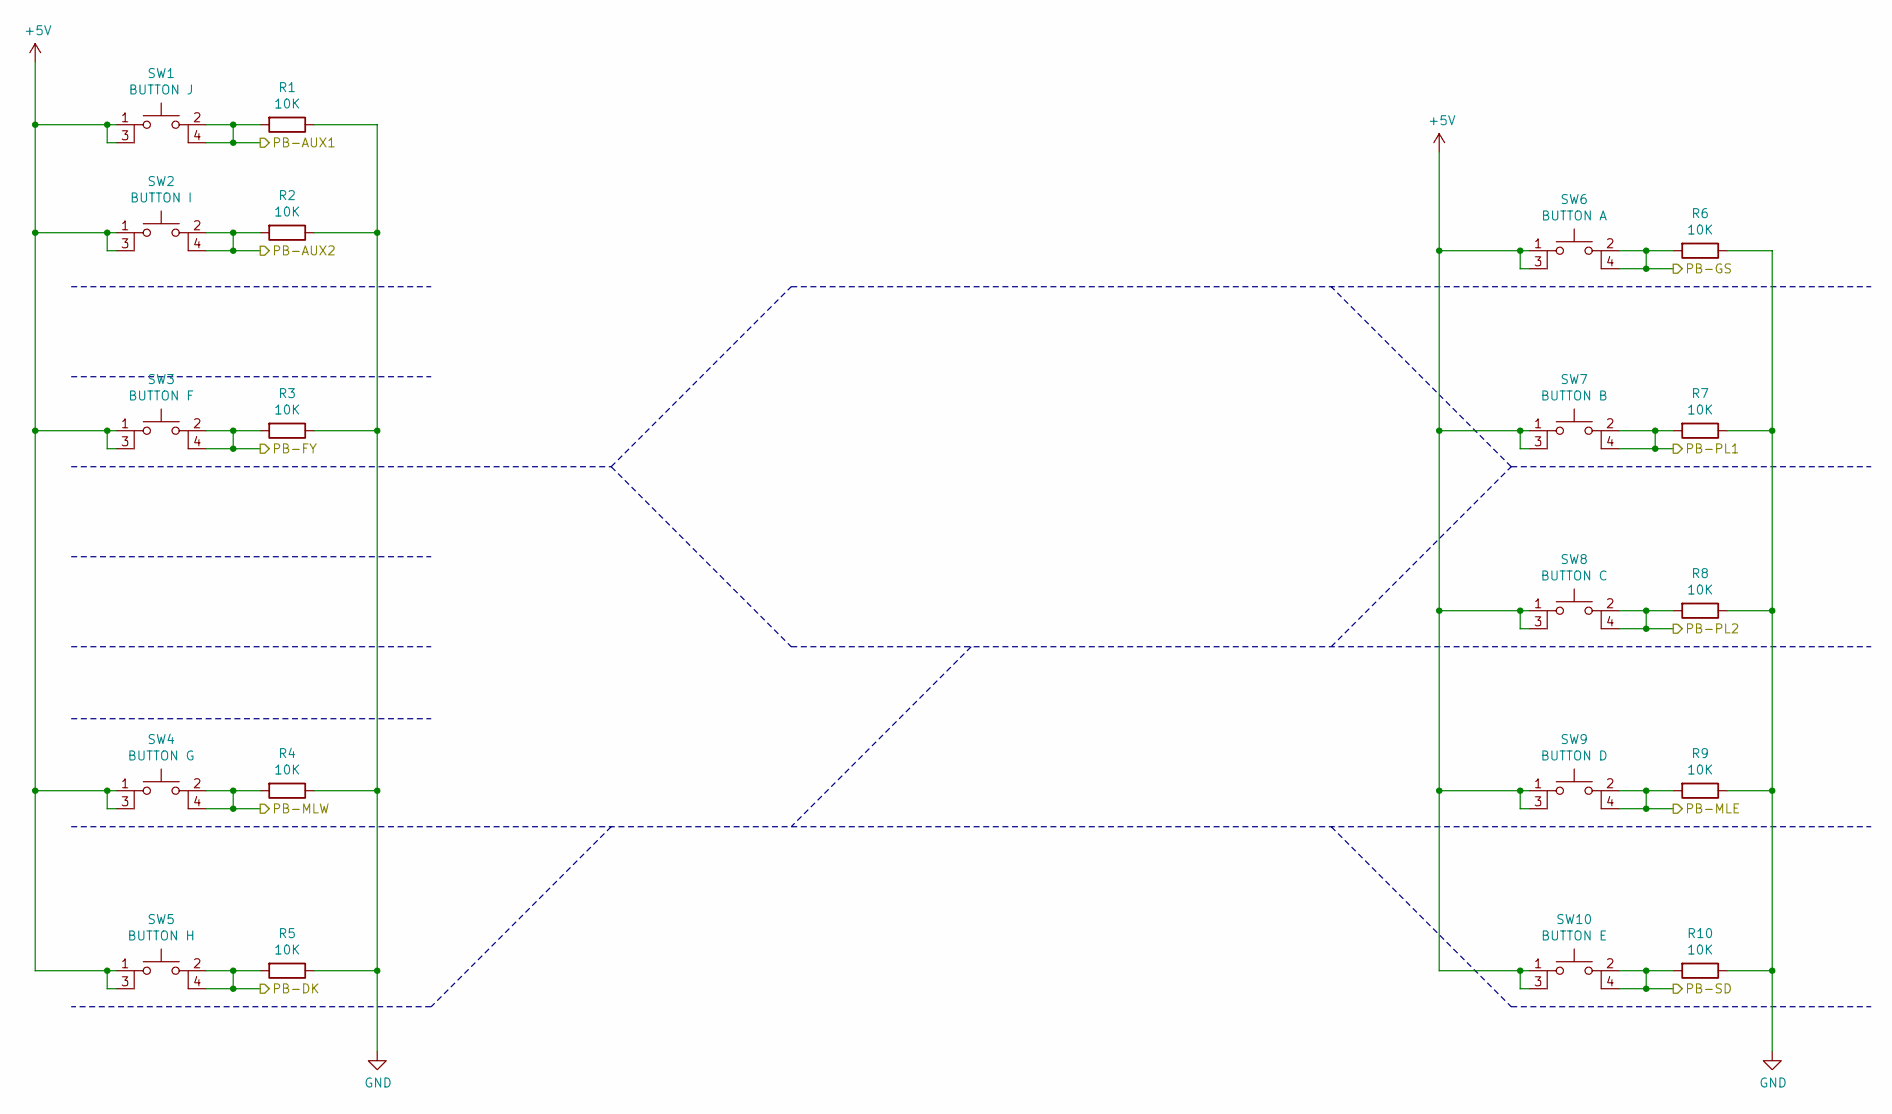
[picture p45: schematic panel-display-buttons.sch]

Parts:
R1, R2, R3, R4, R5, R6, R7, R8, R9, R10: 10K; R_Axial_DIN0207_L6.3mm_D2.5mm_P10.16mm_Horizontal
SW1: BUTTON J; SW_PUSH_6mm_4pin
SW2: BUTTON I; SW_PUSH_6mm_4pin
SW3: BUTTON F; SW_PUSH_6mm_4pin
SW4: BUTTON G; SW_PUSH_6mm_4pin
SW5: BUTTON H; SW_PUSH_6mm_4pin
SW6: BUTTON A; SW_PUSH_6mm_4pin
SW7: BUTTON B; SW_PUSH_6mm_4pin
SW8: BUTTON C; SW_PUSH_6mm_4pin
SW9: BUTTON D; SW_PUSH_6mm_4pin
SW10: BUTTON E; SW_PUSH_6mm_4pin

Connections:
+5V: SW1.1, SW1.3, SW2.1, SW2.3, SW3.1, SW3.3, SW4.1, SW4.3, SW5.1, SW5.3, SW6.1, SW6.3, SW7.1, SW7.3, SW8.1, SW8.3, SW9.1, SW9.3, SW10.1, SW10.3; also elsewhere on the board
/Panel Display Buttons/PB-AUX1: R1.2, SW1.2, SW1.4; also elsewhere on the board
/Panel Display Buttons/PB-AUX2: R2.2, SW2.2, SW2.4; also elsewhere on the board
/Panel Display Buttons/PB-DK: R5.2, SW5.2, SW5.4; also elsewhere on the board
/Panel Display Buttons/PB-FY: R3.2, SW3.2, SW3.4; also elsewhere on the board
/Panel Display Buttons/PB-GS: R6.2, SW6.2, SW6.4; also elsewhere on the board
/Panel Display Buttons/PB-MLE: R9.2, SW9.2, SW9.4; also elsewhere on the board
/Panel Display Buttons/PB-MLW: R4.2, SW4.2, SW4.4; also elsewhere on the board
/Panel Display Buttons/PB-PL1: R7.2, SW7.2, SW7.4; also elsewhere on the board
/Panel Display Buttons/PB-PL2: R8.2, SW8.2, SW8.4; also elsewhere on the board
/Panel Display Buttons/PB-SD: R10.2, SW10.2, SW10.4; also elsewhere on the board
GND: R1.1, R2.1, R3.1, R4.1, R5.1, R6.1, R7.1, R8.1, R9.1, R10.1; also elsewhere on the board

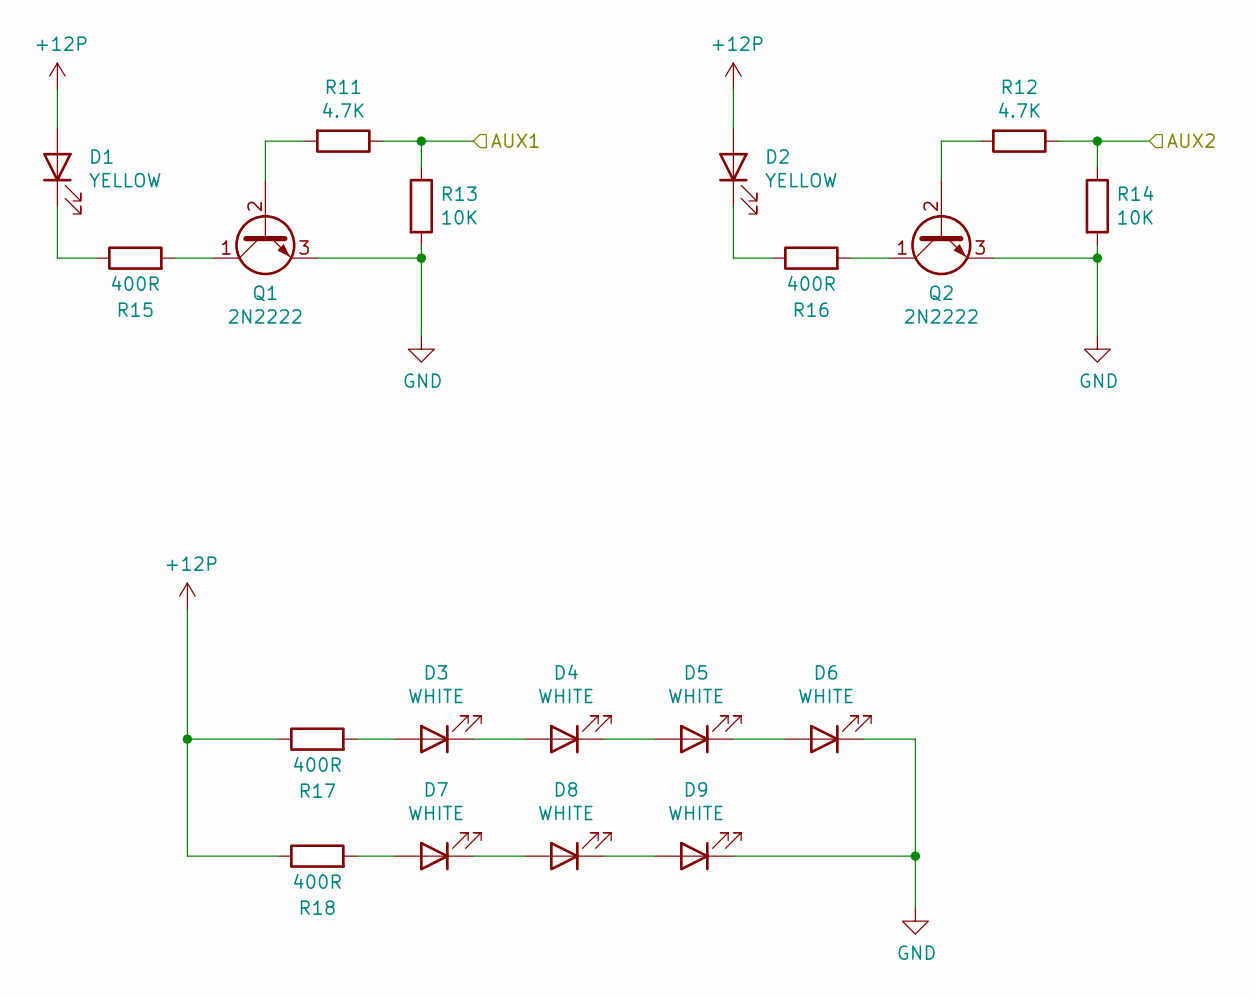
[picture p46: schematic led-aux.sch]

Parts:
D1, D2: YELLOW; LED_D5.0mm
D3, D4, D5, D6, D7, D8, D9: WHITE; LED_D5.0mm
Q1, Q2: 2N2222; TO-92_Inline_Wide
R11, R12: 4.7K; R_Axial_DIN0207_L6.3mm_D2.5mm_P10.16mm_Horizontal
R13, R14: 10K; R_Axial_DIN0207_L6.3mm_D2.5mm_P10.16mm_Horizontal
R15, R16, R17, R18: 400R; R_Axial_DIN0207_L6.3mm_D2.5mm_P10.16mm_Horizontal

Connections:
+12P: D1.2 (A), D2.2 (A), R17.1, R18.1; also elsewhere on the board
/LED Aux/AUX1: R11.1, R13.1; also elsewhere on the board
/LED Aux/AUX2: R12.1, R14.1; also elsewhere on the board
GND: D6.1 (K), D9.1 (K), Q1.3 (E), Q2.3 (E), R13.2, R14.2; also elsewhere on the board
unnamed: D1.1 (K), R15.1
unnamed: D2.1 (K), R16.1
unnamed: D3.1 (K), D4.2 (A)
unnamed: D3.2 (A), R17.2
unnamed: D4.1 (K), D5.2 (A)
unnamed: D5.1 (K), D6.2 (A)
unnamed: D7.1 (K), D8.2 (A)
unnamed: D7.2 (A), R18.2
unnamed: D8.1 (K), D9.2 (A)
unnamed: Q1.1 (C), R15.2
unnamed: Q1.2 (B), R11.2
unnamed: Q2.1 (C), R16.2
unnamed: Q2.2 (B), R12.2

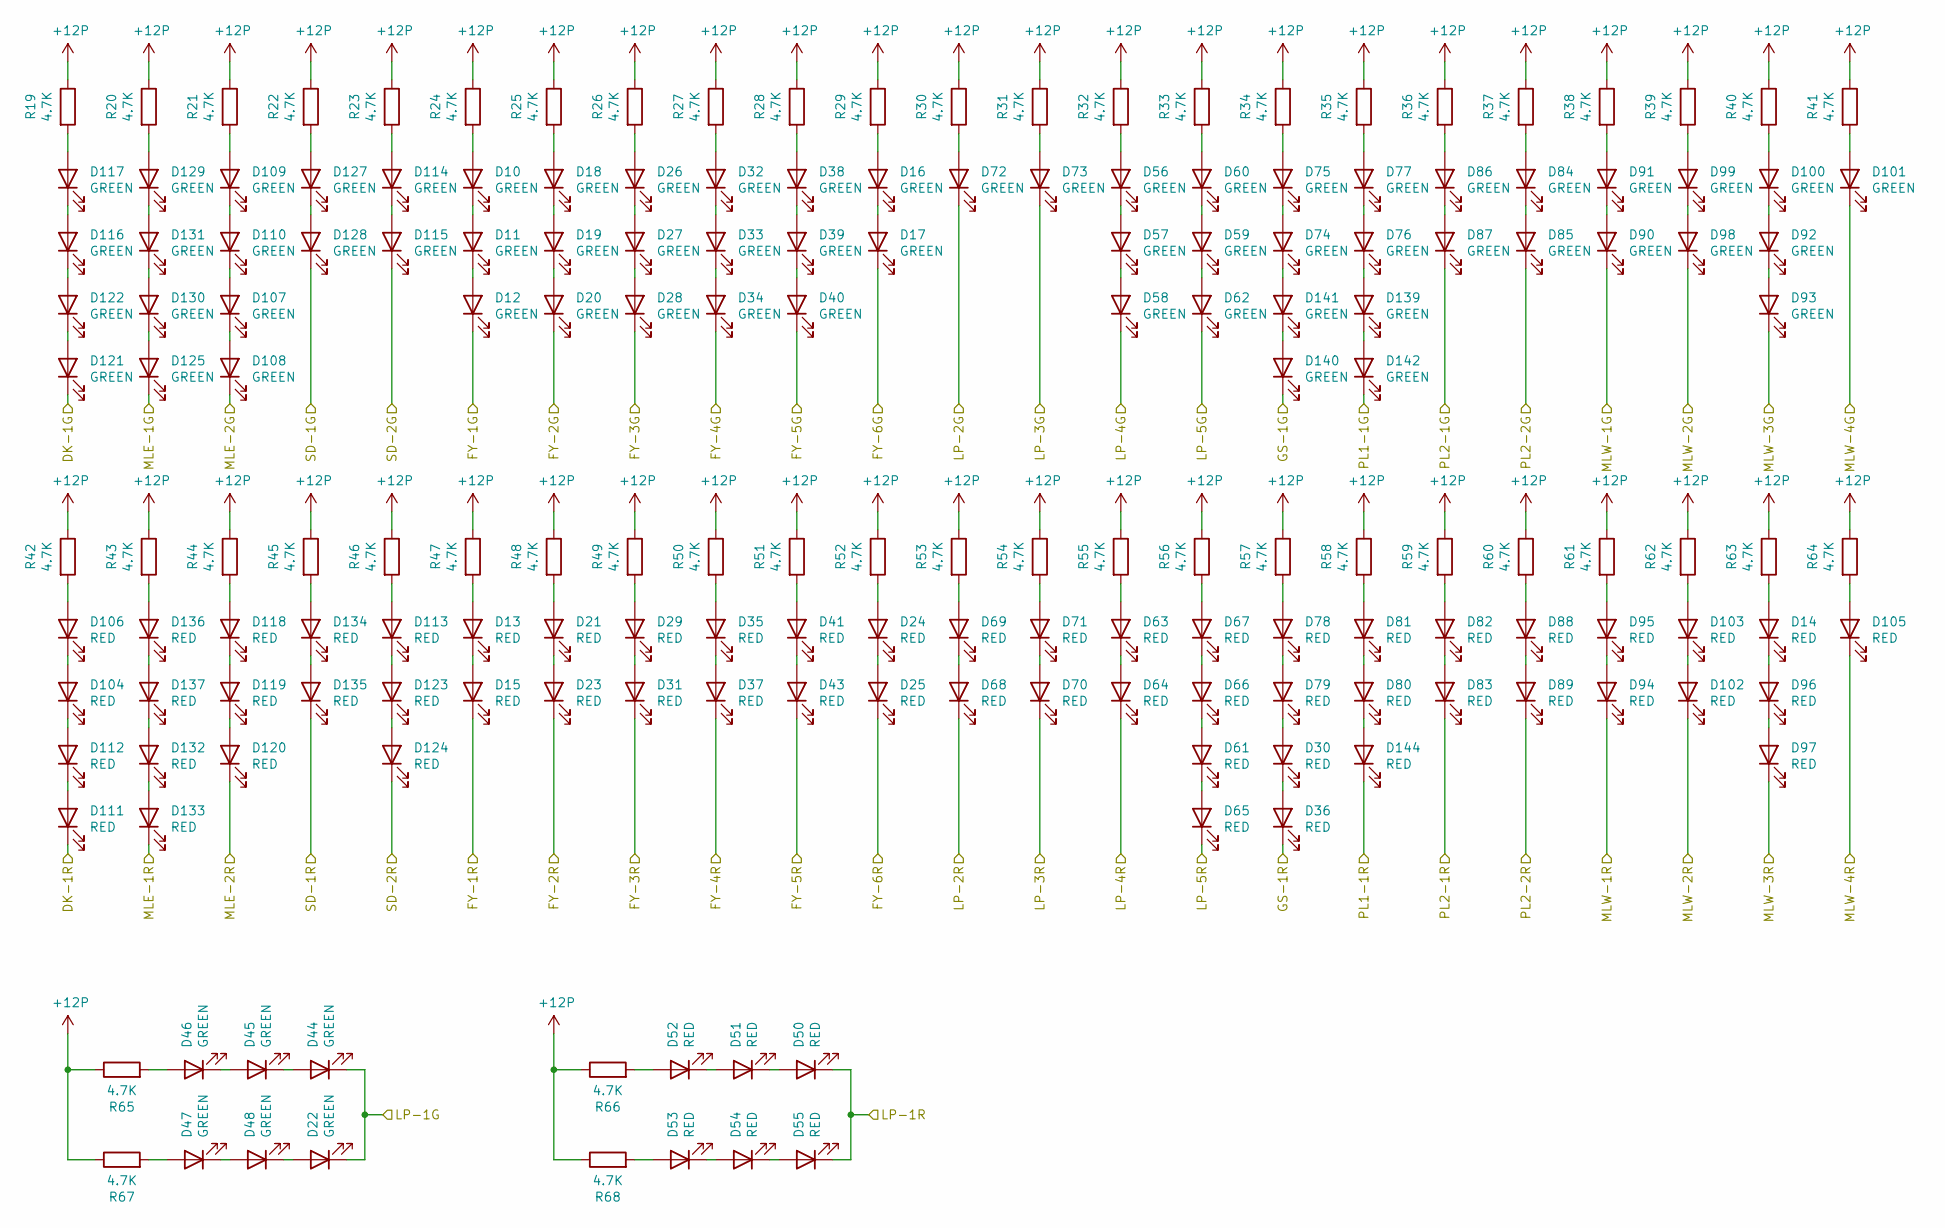
[picture p47: schematic led-track.sch]

Parts:
D10, D11, D12, D16, D17, D18, D19, D20, D22, D26, D27, D28, D32, D33, D34, D38, D39, D40, D44, D45, D46, D47, D48, D56, D57, D58, D59, D60, D62, D72, D73, D74, D75, D76, D77, D84, D85, D86, D87, D90, D91, D92, D93, D98, D99, D100, D101, D107, D108, D109, D110, D114, D115, D116, D117, D121, D122, D125, D127, D128, D129, D130, D131, D139, D140, D141, D142: GREEN; LED_D5.0mm
D13, D14, D15, D21, D23, D24, D25, D29, D30, D31, D35, D36, D37, D41, D43, D50, D51, D52, D53, D54, D55, D61, D63, D64, D65, D66, D67, D68, D69, D70, D71, D78, D79, D80, D81, D82, D83, D88, D89, D94, D95, D96, D97, D102, D103, D104, D105, D106, D111, D112, D113, D118, D119, D120, D123, D124, D132, D133, D134, D135, D136, D137, D144: RED; LED_D5.0mm
R19, R20, R21, R22, R23, R24, R25, R26, R27, R28, R29, R30, R31, R32, R33, R34, R35, R36, R37, R38, R39, R40, R41, R42, R43, R44, R45, R46, R47, R48, R49, R50, R51, R52, R53, R54, R55, R56, R57, R58, R59, R60, R61, R62, R63, R64, R65, R66, R67, R68: 4.7K; R_Axial_DIN0207_L6.3mm_D2.5mm_P10.16mm_Horizontal

Connections:
+12P: R19.1, R20.1, R21.1, R22.1, R23.1, R24.1, R25.1, R26.1, R27.1, R28.1, R29.1, R30.1, R31.1, R32.1, R33.1, R34.1, R35.1, R36.1, R37.1, R38.1, R39.1, R40.1, R41.1, R42.1, R43.1, R44.1, R45.1, R46.1, R47.1, R48.1, R49.1, R50.1, R51.1, R52.1, R53.1, R54.1, R55.1, R56.1, R57.1, R58.1, R59.1, R60.1, R61.1, R62.1, R63.1, R64.1, R65.1, R66.1, R67.1, R68.1; also elsewhere on the board
/LED1: D121.1 (K); also elsewhere on the board
/LED2: D125.1 (K); also elsewhere on the board
/LED3: D108.1 (K); also elsewhere on the board
/LED4: D128.1 (K); also elsewhere on the board
/LED5: D115.1 (K); also elsewhere on the board
/LED6: D12.1 (K); also elsewhere on the board
/LED7: D20.1 (K); also elsewhere on the board
/LED8: D28.1 (K); also elsewhere on the board
/LED9: D34.1 (K); also elsewhere on the board
/LED10: D40.1 (K); also elsewhere on the board
/LED11: D17.1 (K); also elsewhere on the board
/LED12: D22.1 (K), D44.1 (K); also elsewhere on the board
/LED13: D72.1 (K); also elsewhere on the board
/LED14: D73.1 (K); also elsewhere on the board
/LED15: D58.1 (K); also elsewhere on the board
/LED16: D62.1 (K); also elsewhere on the board
/LED17: D140.1 (K); also elsewhere on the board
/LED18: D142.1 (K); also elsewhere on the board
/LED19: D87.1 (K); also elsewhere on the board
/LED20: D85.1 (K); also elsewhere on the board
/LED21: D90.1 (K); also elsewhere on the board
/LED22: D98.1 (K); also elsewhere on the board
/LED23: D93.1 (K); also elsewhere on the board
/LED24: D101.1 (K); also elsewhere on the board
/LED25: D111.1 (K); also elsewhere on the board
/LED26: D133.1 (K); also elsewhere on the board
/LED27: D120.1 (K); also elsewhere on the board
/LED28: D135.1 (K); also elsewhere on the board
/LED29: D124.1 (K); also elsewhere on the board
/LED30: D15.1 (K); also elsewhere on the board
/LED31: D23.1 (K); also elsewhere on the board
/LED32: D31.1 (K); also elsewhere on the board
/LED33: D37.1 (K); also elsewhere on the board
/LED34: D43.1 (K); also elsewhere on the board
/LED35: D25.1 (K); also elsewhere on the board
/LED36: D50.1 (K), D55.1 (K); also elsewhere on the board
/LED37: D68.1 (K); also elsewhere on the board
/LED38: D70.1 (K); also elsewhere on the board
/LED39: D64.1 (K); also elsewhere on the board
/LED40: D65.1 (K); also elsewhere on the board
/LED41: D36.1 (K); also elsewhere on the board
/LED42: D144.1 (K); also elsewhere on the board
/LED43: D83.1 (K); also elsewhere on the board
/LED44: D89.1 (K); also elsewhere on the board
/LED45: D94.1 (K); also elsewhere on the board
/LED46: D102.1 (K); also elsewhere on the board
/LED47: D97.1 (K); also elsewhere on the board
/LED48: D105.1 (K); also elsewhere on the board
unnamed: D10.1 (K), D11.2 (A)
unnamed: D10.2 (A), R24.2
unnamed: D11.1 (K), D12.2 (A)
unnamed: D13.1 (K), D15.2 (A)
unnamed: D13.2 (A), R47.2
unnamed: D14.1 (K), D96.2 (A)
unnamed: D14.2 (A), R63.2
unnamed: D16.1 (K), D17.2 (A)
unnamed: D16.2 (A), R29.2
unnamed: D18.1 (K), D19.2 (A)
unnamed: D18.2 (A), R25.2
unnamed: D19.1 (K), D20.2 (A)
unnamed: D21.1 (K), D23.2 (A)
unnamed: D21.2 (A), R48.2
unnamed: D22.2 (A), D48.1 (K)
unnamed: D24.1 (K), D25.2 (A)
unnamed: D24.2 (A), R52.2
unnamed: D26.1 (K), D27.2 (A)
unnamed: D26.2 (A), R26.2
unnamed: D27.1 (K), D28.2 (A)
unnamed: D29.1 (K), D31.2 (A)
unnamed: D29.2 (A), R49.2
unnamed: D30.1 (K), D36.2 (A)
unnamed: D30.2 (A), D79.1 (K)
unnamed: D32.1 (K), D33.2 (A)
unnamed: D32.2 (A), R27.2
unnamed: D33.1 (K), D34.2 (A)
unnamed: D35.1 (K), D37.2 (A)
unnamed: D35.2 (A), R50.2
unnamed: D38.1 (K), D39.2 (A)
unnamed: D38.2 (A), R28.2
unnamed: D39.1 (K), D40.2 (A)
unnamed: D41.1 (K), D43.2 (A)
unnamed: D41.2 (A), R51.2
unnamed: D44.2 (A), D45.1 (K)
unnamed: D45.2 (A), D46.1 (K)
unnamed: D46.2 (A), R65.2
unnamed: D47.1 (K), D48.2 (A)
unnamed: D47.2 (A), R67.2
unnamed: D50.2 (A), D51.1 (K)
unnamed: D51.2 (A), D52.1 (K)
unnamed: D52.2 (A), R66.2
unnamed: D53.1 (K), D54.2 (A)
unnamed: D53.2 (A), R68.2
unnamed: D54.1 (K), D55.2 (A)
unnamed: D56.1 (K), D57.2 (A)
unnamed: D56.2 (A), R32.2
unnamed: D57.1 (K), D58.2 (A)
unnamed: D59.1 (K), D62.2 (A)
unnamed: D59.2 (A), D60.1 (K)
unnamed: D60.2 (A), R33.2
unnamed: D61.1 (K), D65.2 (A)
unnamed: D61.2 (A), D66.1 (K)
unnamed: D63.1 (K), D64.2 (A)
unnamed: D63.2 (A), R55.2
unnamed: D66.2 (A), D67.1 (K)
unnamed: D67.2 (A), R56.2
unnamed: D68.2 (A), D69.1 (K)
unnamed: D69.2 (A), R53.2
unnamed: D70.2 (A), D71.1 (K)
unnamed: D71.2 (A), R54.2
unnamed: D72.2 (A), R30.2
unnamed: D73.2 (A), R31.2
unnamed: D74.2 (A), D75.1 (K)
unnamed: D75.2 (A), R34.2
unnamed: D76.2 (A), D77.1 (K)
unnamed: D77.2 (A), R35.2
unnamed: D78.1 (K), D79.2 (A)
unnamed: D78.2 (A), R57.2
unnamed: D80.2 (A), D81.1 (K)
unnamed: D81.2 (A), R58.2
unnamed: D82.1 (K), D83.2 (A)
unnamed: D82.2 (A), R59.2
unnamed: D84.1 (K), D85.2 (A)
unnamed: D84.2 (A), R37.2
unnamed: D86.1 (K), D87.2 (A)
unnamed: D86.2 (A), R36.2
unnamed: D88.1 (K), D89.2 (A)
unnamed: D88.2 (A), R60.2
unnamed: D90.2 (A), D91.1 (K)
unnamed: D91.2 (A), R38.2
unnamed: D92.1 (K), D93.2 (A)
unnamed: D94.2 (A), D95.1 (K)
unnamed: D95.2 (A), R61.2
unnamed: D96.1 (K), D97.2 (A)
unnamed: D98.2 (A), D99.1 (K)
unnamed: D99.2 (A), R39.2
unnamed: D92.2 (A), D100.1 (K)
unnamed: D100.2 (A), R40.2
unnamed: D101.2 (A), R41.2
unnamed: D102.2 (A), D103.1 (K)
unnamed: D103.2 (A), R62.2
unnamed: D104.1 (K), D112.2 (A)
unnamed: D104.2 (A), D106.1 (K)
unnamed: D105.2 (A), R64.2
unnamed: D106.2 (A), R42.2
unnamed: D107.1 (K), D108.2 (A)
unnamed: D107.2 (A), D110.1 (K)
unnamed: D109.1 (K), D110.2 (A)
unnamed: D109.2 (A), R21.2
unnamed: D111.2 (A), D112.1 (K)
unnamed: D113.1 (K), D123.2 (A)
unnamed: D113.2 (A), R46.2
unnamed: D114.1 (K), D115.2 (A)
unnamed: D114.2 (A), R23.2
unnamed: D116.1 (K), D122.2 (A)
unnamed: D116.2 (A), D117.1 (K)
unnamed: D117.2 (A), R19.2
unnamed: D118.1 (K), D119.2 (A)
unnamed: D118.2 (A), R44.2
unnamed: D119.1 (K), D120.2 (A)
unnamed: D121.2 (A), D122.1 (K)
unnamed: D123.1 (K), D124.2 (A)
unnamed: D125.2 (A), D130.1 (K)
unnamed: D127.1 (K), D128.2 (A)
unnamed: D127.2 (A), R22.2
unnamed: D129.1 (K), D131.2 (A)
unnamed: D129.2 (A), R20.2
unnamed: D130.2 (A), D131.1 (K)
unnamed: D132.1 (K), D133.2 (A)
unnamed: D132.2 (A), D137.1 (K)
unnamed: D134.1 (K), D135.2 (A)
unnamed: D134.2 (A), R45.2
unnamed: D136.1 (K), D137.2 (A)
unnamed: D136.2 (A), R43.2
unnamed: D139.1 (K), D142.2 (A)
unnamed: D76.1 (K), D139.2 (A)
unnamed: D140.2 (A), D141.1 (K)
unnamed: D74.1 (K), D141.2 (A)
unnamed: D80.1 (K), D144.2 (A)

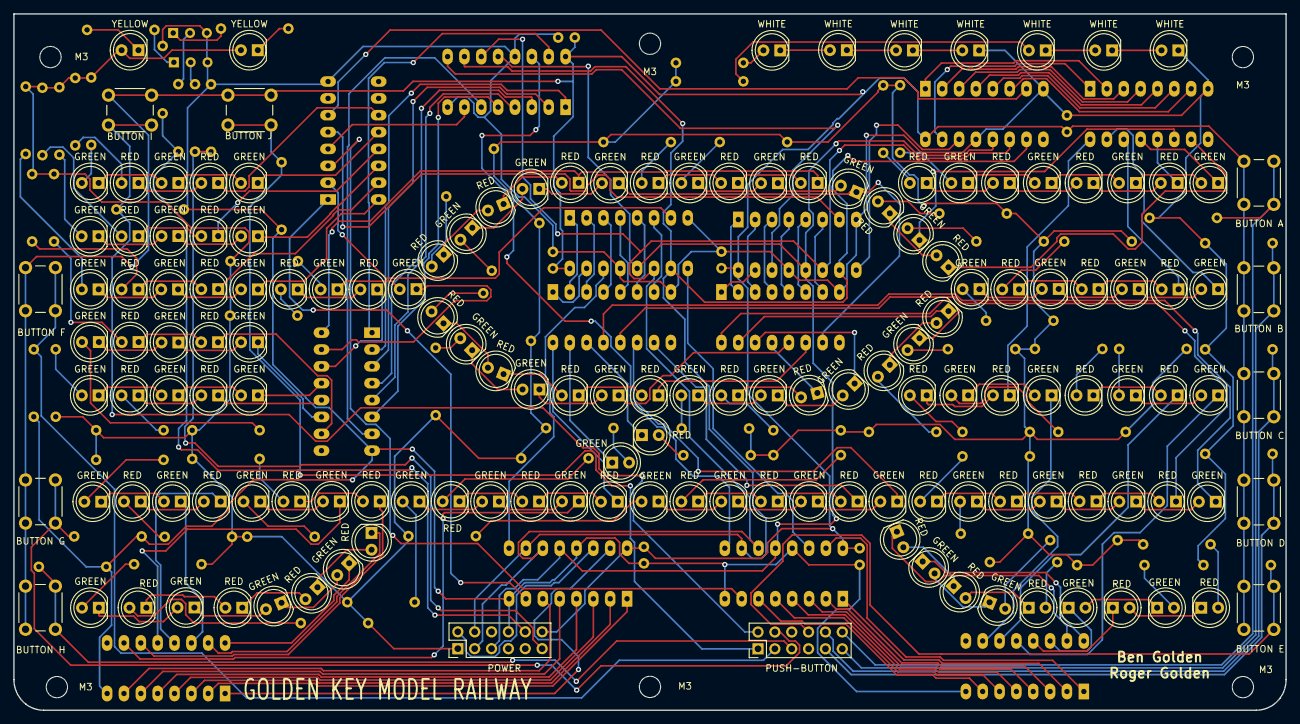
[picture p48: board panel-display.kicad_pcb from above]

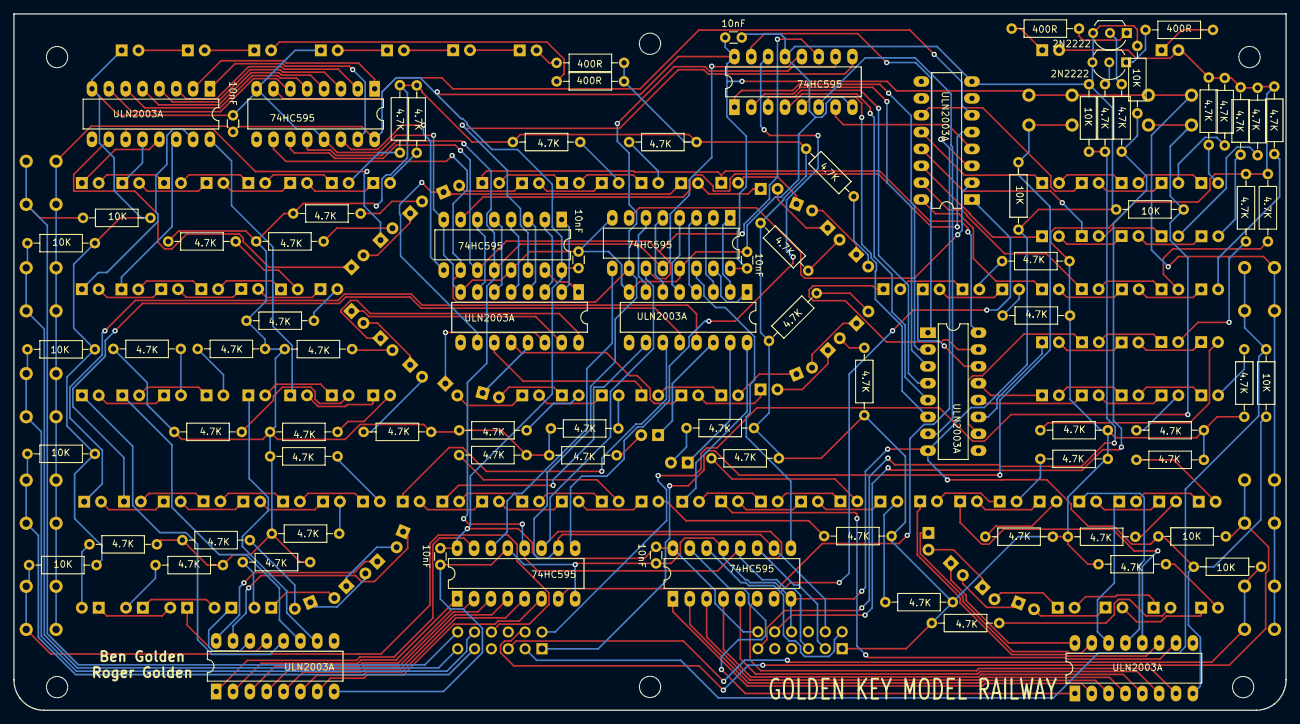
[picture p49: board panel-display.kicad_pcb from below]

Board: 2 copper layers, 191.7 x 104.9 mm, 240 parts (89 on the bottom side), 263 nets.
