CarnivalBen/golden-key/panel/pcb-main/panel-main.kicad_pcb

## KiCad design panel/pcb-main/panel-main.kicad_pcb (2020-08-14)

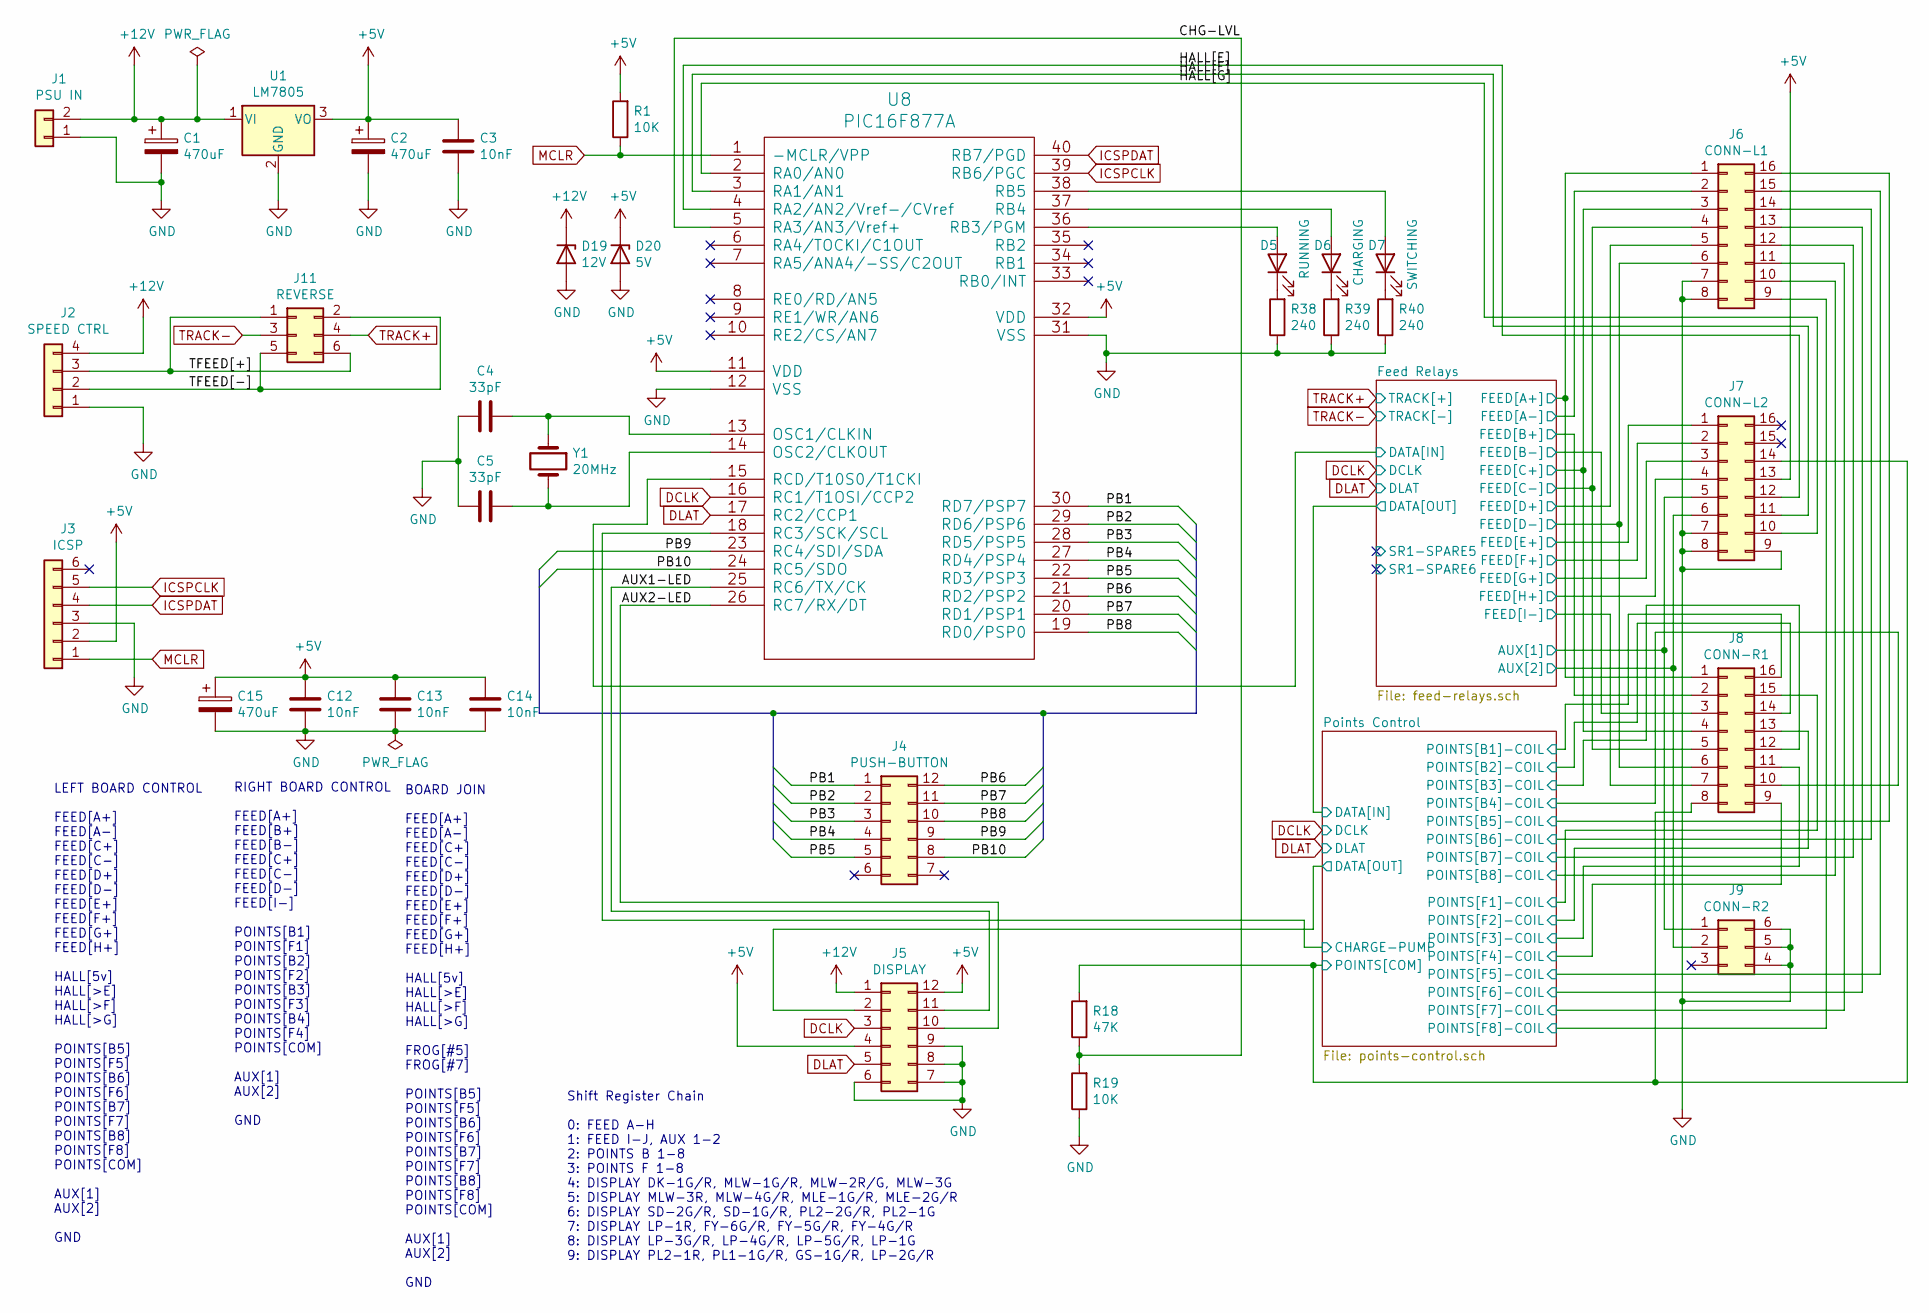
[picture p50: schematic panel-main.sch]

Parts:
C1, C2, C15: 470uF; CP_Radial_D10.0mm_P5.00mm
C3, C12, C13, C14: 10nF; C_Disc_D4.7mm_W2.5mm_P5.00mm
C4, C5: 33pF; C_Disc_D3.4mm_W2.1mm_P2.50mm
D5: RUNNING; LED_D5.0mm
D6: CHARGING; LED_D5.0mm
D7: SWITCHING; LED_D5.0mm
D19: 12V; D_DO-15_P10.16mm_Horizontal
D20: 5V; D_DO-15_P10.16mm_Horizontal
J1: PSU IN; Wire_Pads_Edge_1x2
J2: SPEED CTRL; DIN_Socket_Edge_Solder_4pin
J3: ICSP; Pin_Header_Straight_1x06_Pitch2.54mm
J4: PUSH-BUTTON; Pin_Header_Straight_2x06_Pitch2.54mm
J5: DISPLAY; Pin_Header_Straight_2x06_Pitch2.54mm
J6: CONN-L1; Wire_Pads_Edge_2x8
J7: CONN-L2; Wire_Pads_Edge_2x8
J8: CONN-R1; Wire_Pads_Edge_2x8
J9: CONN-R2; Wire_Pads_Edge_2x3
J11: REVERSE; Pin_Header_Straight_2x03_Pitch2.54mm
R1, R19: 10K; R_Axial_DIN0207_L6.3mm_D2.5mm_P10.16mm_Horizontal
R18: 47K; R_Axial_DIN0207_L6.3mm_D2.5mm_P10.16mm_Horizontal
R38, R39, R40: 240; R_Axial_DIN0207_L6.3mm_D2.5mm_P10.16mm_Horizontal
U1: LM7805; TO-220-3_Horizontal
U8: PIC16F877A; DIP-40_W15.24mm_LongPads
Y1: 20MHz; Crystal_HC49-U_Vertical

Connections:
+5V: C2.1, C3.1, C12.1, C13.1, C14.1, C15.1, D20.1 (K), J3.2, J5.4, J5.12, J7.13, R1.2, U1.3 (VO), U8.11 (VDD), U8.32 (VDD); also elsewhere on the board
+12V: C1.1, D19.1 (K), J1.2, J2.4, J5.1, U1.1 (VI); also elsewhere on the board
/AUX1-LED: J5.11, U8.25 (RC6/TX/CK)
/AUX2-LED: J5.10, U8.26 (RC7/RX/DT)
/CHG-LVL: R18.1, R19.2, U8.5 (RA3/AN3/Vref+)
/Feed Relays/AUX[1]: J7.5, J9.1; also elsewhere on the board
/Feed Relays/AUX[2]: J7.6, J9.2; also elsewhere on the board
/Feed Relays/DATA[IN]: U8.15 (RCD/T10S0/T1CKI); also elsewhere on the board
/Feed Relays/FEED[A+]: J6.1, J8.1; also elsewhere on the board
/Feed Relays/FEED[A-]: J6.2; also elsewhere on the board
/Feed Relays/FEED[B+]: J8.2; also elsewhere on the board
/Feed Relays/FEED[B-]: J8.3; also elsewhere on the board
/Feed Relays/FEED[C+]: J6.3, J8.4; also elsewhere on the board
/Feed Relays/FEED[C-]: J6.4, J8.5; also elsewhere on the board
/Feed Relays/FEED[D+]: J6.5; also elsewhere on the board
/Feed Relays/FEED[D-]: J6.6, J8.6; also elsewhere on the board
/Feed Relays/FEED[E+]: J7.1; also elsewhere on the board
/Feed Relays/FEED[F+]: J7.2; also elsewhere on the board
/Feed Relays/FEED[G+]: J7.3; also elsewhere on the board
/Feed Relays/FEED[H+]: J7.4; also elsewhere on the board
/Feed Relays/FEED[I-]: J8.7; also elsewhere on the board
/HALL[E]: J7.12, U8.4 (RA2/AN2/Vref-/CVref)
/HALL[F]: J7.11, U8.3 (RA1/AN1)
/HALL[G]: J7.10, U8.2 (RA0/AN0)
/PB1: J4.1, U8.30 (RD7/PSP7)
/PB2: J4.2, U8.29 (RD6/PSP6)
/PB3: J4.3, U8.28 (RD5/PSP5)
/PB4: J4.4, U8.27 (RD4/PSP4)
/PB5: J4.5, U8.22 (RD3/PSP3)
/PB6: J4.12, U8.21 (RD2/PSP2)
/PB7: J4.11, U8.20 (RD1/PSP1)
/PB8: J4.10, U8.19 (RD0/PSP0)
/PB9: J4.9, U8.23 (RC4/SDI/SDA)
/PB10: J4.8, U8.24 (RC5/SDO)
/Points Control/CHARGE-PUMP: U8.18 (RC3/SCK/SCL); also elsewhere on the board
/Points Control/DATA[OUT]: J5.2; also elsewhere on the board
/Points Control/POINTS[B1]-COIL: J8.16; also elsewhere on the board
/Points Control/POINTS[B2]-COIL: J8.14; also elsewhere on the board
/Points Control/POINTS[B3]-COIL: J8.12; also elsewhere on the board
/Points Control/POINTS[B4]-COIL: J8.10; also elsewhere on the board
/Points Control/POINTS[B5]-COIL: J6.16; also elsewhere on the board
/Points Control/POINTS[B6]-COIL: J6.14; also elsewhere on the board
/Points Control/POINTS[B7]-COIL: J6.12; also elsewhere on the board
/Points Control/POINTS[B8]-COIL: J6.10; also elsewhere on the board
/Points Control/POINTS[COM]: J7.14, J8.8, R18.2; also elsewhere on the board
/Points Control/POINTS[F1]-COIL: J8.15; also elsewhere on the board
/Points Control/POINTS[F2]-COIL: J8.13; also elsewhere on the board
/Points Control/POINTS[F3]-COIL: J8.11; also elsewhere on the board
/Points Control/POINTS[F4]-COIL: J8.9; also elsewhere on the board
/Points Control/POINTS[F5]-COIL: J6.15; also elsewhere on the board
/Points Control/POINTS[F6]-COIL: J6.13; also elsewhere on the board
/Points Control/POINTS[F7]-COIL: J6.11; also elsewhere on the board
/Points Control/POINTS[F8]-COIL: J6.9; also elsewhere on the board
/TFEED[+]: J2.3, J11.1, J11.6
/TFEED[-]: J2.2, J11.2, J11.5
DCLK: J5.3, U8.16 (RC1/T1OSI/CCP2); also elsewhere on the board
DLAT: J5.5, U8.17 (RC2/CCP1); also elsewhere on the board
GND: C1.2, C2.2, C3.2, C4.2, C5.2, C12.2, C13.2, C14.2, C15.2, D19.2 (A), D20.2 (A), J1.1, J2.1, J3.3, J5.6, J5.7, J5.8, J5.9, J6.7, J6.8, J7.7, J7.8, J7.9, J9.4, J9.5, J9.6, R19.1, R38.1, R39.1, R40.1, U1.2 (GND), U8.12 (VSS), U8.31 (VSS); also elsewhere on the board
ICSPCLK: J3.5, U8.39 (RB6/PGC)
ICSPDAT: J3.4, U8.40 (RB7/PGD)
MCLR: J3.1, R1.1, U8.1 (-MCLR/VPP)
unnamed: C4.1, U8.13 (OSC1/CLKIN), Y1.1
unnamed: C5.1, U8.14 (OSC2/CLKOUT), Y1.2
unnamed: D5.1 (K), R38.2
unnamed: D5.2 (A), U8.36 (RB3/PGM)
unnamed: D6.1 (K), R39.2
unnamed: D6.2 (A), U8.37 (RB4)
unnamed: D7.1 (K), R40.2
unnamed: D7.2 (A), U8.38 (RB5)
TRACK+: J11.4; also elsewhere on the board
TRACK-: J11.3; also elsewhere on the board

Notes on the sheet:
Shift Register Chain 0: FEED A-H 1: FEED I-J, AUX 1-2 2: POINTS B 1-8 3: POINTS F 1-8 4: DISPLAY DK-1G/R, MLW-1G/R, MLW-2R/G, MLW-3G 5: DISPLAY MLW-3R, MLW-4G/R, MLE-1G/R, MLE-2G/R 6: DISPLAY SD-2G/R, SD-1G/R, PL2-2G/R, PL2-1G 7: DISPLAY LP-1R, FY-6G/R, FY-5G/R, FY-4G/R 8: DISPLAY LP-3G/R, LP-4G/R,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
LEFT BOARD CONTROL FEED[A+] FEED[A-] FEED[C+] FEED[C-] FEED[D+] FEED[D-] FEED[E+] FEED[F+] FEED[G+] FEED[H+] HALL[5v] HALL[>E] HALL[>F] HALL[>G] POINTS[B5] POINTS[F5] POINTS[B6] POINTS[F6] POINTS[B7] POINTS[F7] POINTS[B8] POINTS[F8] POINTS[COM] AUX[1] AUX[2] GND
RIGHT BOARD CONTROL FEED[A+] FEED[B+] FEED[B-] FEED[C+] FEED[C-] FEED[D-] FEED[I-] POINTS[B1] POINTS[F1] POINTS[B2] POINTS[F2] POINTS[B3] POINTS[F3] POINTS[B4] POINTS[F4] POINTS[COM] AUX[1] AUX[2] GND
BOARD JOIN FEED[A+] FEED[A-] FEED[C+] FEED[C-] FEED[D+] FEED[D-] FEED[E+] FEED[F+] FEED[G+] FEED[H+] HALL[5v] HALL[>E] HALL[>F] HALL[>G] FROG[#5] FROG[#7] POINTS[B5] POINTS[F5] POINTS[B6] POINTS[F6] POINTS[B7] POINTS[F7] POINTS[B8] POINTS[F8] POINTS[COM] AUX[1] AUX[2] GND

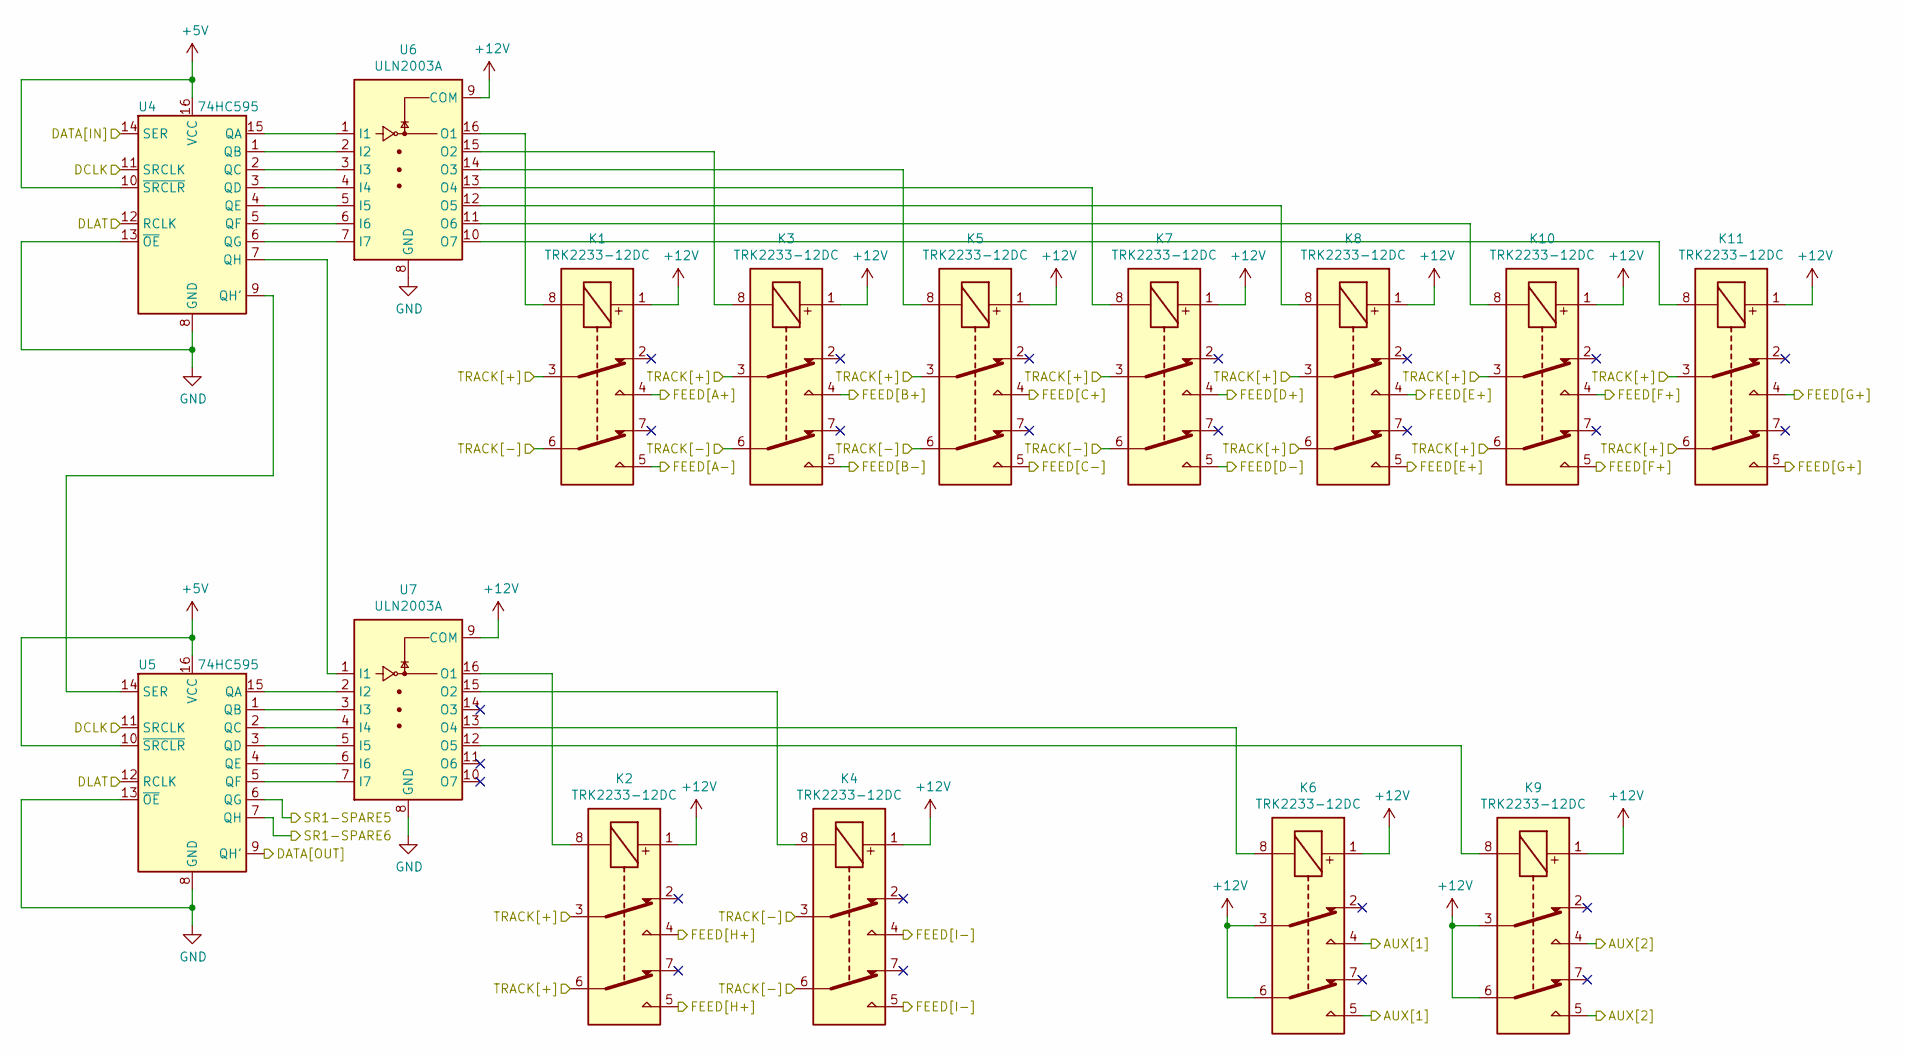
[picture p51: schematic feed-relays.sch]

Parts:
K1, K2, K3, K4, K5, K6, K7, K8, K9, K10, K11: TRK2233-12DC; TRK22X3-XXDC
U4, U5: 74HC595; DIP-16_W7.62mm_LongPads
U6, U7: ULN2003A; DIP-16_W7.62mm_LongPads

Connections:
+5V: U4.10 (~SRCLR), U4.16 (VCC), U5.10 (~SRCLR), U5.16 (VCC); also elsewhere on the board
+12V: K1.1, K2.1, K3.1, K4.1, K5.1, K6.1, K6.3, K6.6, K7.1, K8.1, K9.1, K9.3, K9.6, K10.1, K11.1, U6.9 (COM), U7.9 (COM); also elsewhere on the board
/Feed Relays/AUX[1]: K6.4, K6.5; also elsewhere on the board
/Feed Relays/AUX[2]: K9.4, K9.5; also elsewhere on the board
/Feed Relays/DATA[IN]: U4.14 (SER); also elsewhere on the board
/Feed Relays/FEED[A+]: K1.4; also elsewhere on the board
/Feed Relays/FEED[A-]: K1.5; also elsewhere on the board
/Feed Relays/FEED[B+]: K3.4; also elsewhere on the board
/Feed Relays/FEED[B-]: K3.5; also elsewhere on the board
/Feed Relays/FEED[C+]: K5.4; also elsewhere on the board
/Feed Relays/FEED[C-]: K5.5; also elsewhere on the board
/Feed Relays/FEED[D+]: K7.4; also elsewhere on the board
/Feed Relays/FEED[D-]: K7.5; also elsewhere on the board
/Feed Relays/FEED[E+]: K8.4, K8.5; also elsewhere on the board
/Feed Relays/FEED[F+]: K10.4, K10.5; also elsewhere on the board
/Feed Relays/FEED[G+]: K11.4, K11.5; also elsewhere on the board
/Feed Relays/FEED[H+]: K2.4, K2.5; also elsewhere on the board
/Feed Relays/FEED[I-]: K4.4, K4.5; also elsewhere on the board
/Feed Relays/SR1-SPARE5: U5.6 (QG)
/Feed Relays/SR1-SPARE6: U5.7 (QH)
/Points Control/DATA[IN]: U5.9 (QH'); also elsewhere on the board
DCLK: U4.11 (SRCLK), U5.11 (SRCLK); also elsewhere on the board
DLAT: U4.12 (RCLK), U5.12 (RCLK); also elsewhere on the board
GND: U4.8 (GND), U4.13 (~OE), U5.8 (GND), U5.13 (~OE), U6.8 (GND), U7.8 (GND); also elsewhere on the board
unnamed: K1.8, U6.16 (O1)
unnamed: K2.8, U7.16 (O1)
unnamed: K3.8, U6.15 (O2)
unnamed: K4.8, U7.15 (O2)
unnamed: K5.8, U6.14 (O3)
unnamed: K6.8, U7.13 (O4)
unnamed: K7.8, U6.13 (O4)
unnamed: K8.8, U6.12 (O5)
unnamed: K9.8, U7.12 (O5)
unnamed: K10.8, U6.11 (O6)
unnamed: K11.8, U6.10 (O7)
unnamed: U4.1 (QB), U6.2 (I2)
unnamed: U4.2 (QC), U6.3 (I3)
unnamed: U4.3 (QD), U6.4 (I4)
unnamed: U4.4 (QE), U6.5 (I5)
unnamed: U4.5 (QF), U6.6 (I6)
unnamed: U4.6 (QG), U6.7 (I7)
unnamed: U4.7 (QH), U7.1 (I1)
unnamed: U4.9 (QH'), U5.14 (SER)
unnamed: U4.15 (QA), U6.1 (I1)
unnamed: U5.1 (QB), U7.3 (I3)
unnamed: U5.2 (QC), U7.4 (I4)
unnamed: U5.3 (QD), U7.5 (I5)
unnamed: U5.4 (QE), U7.6 (I6)
unnamed: U5.5 (QF), U7.7 (I7)
unnamed: U5.15 (QA), U7.2 (I2)
TRACK+: K1.3, K2.3, K2.6, K3.3, K5.3, K7.3, K8.3, K8.6, K10.3, K10.6, K11.3, K11.6; also elsewhere on the board
TRACK-: K1.6, K3.6, K4.3, K4.6, K5.6, K7.6; also elsewhere on the board

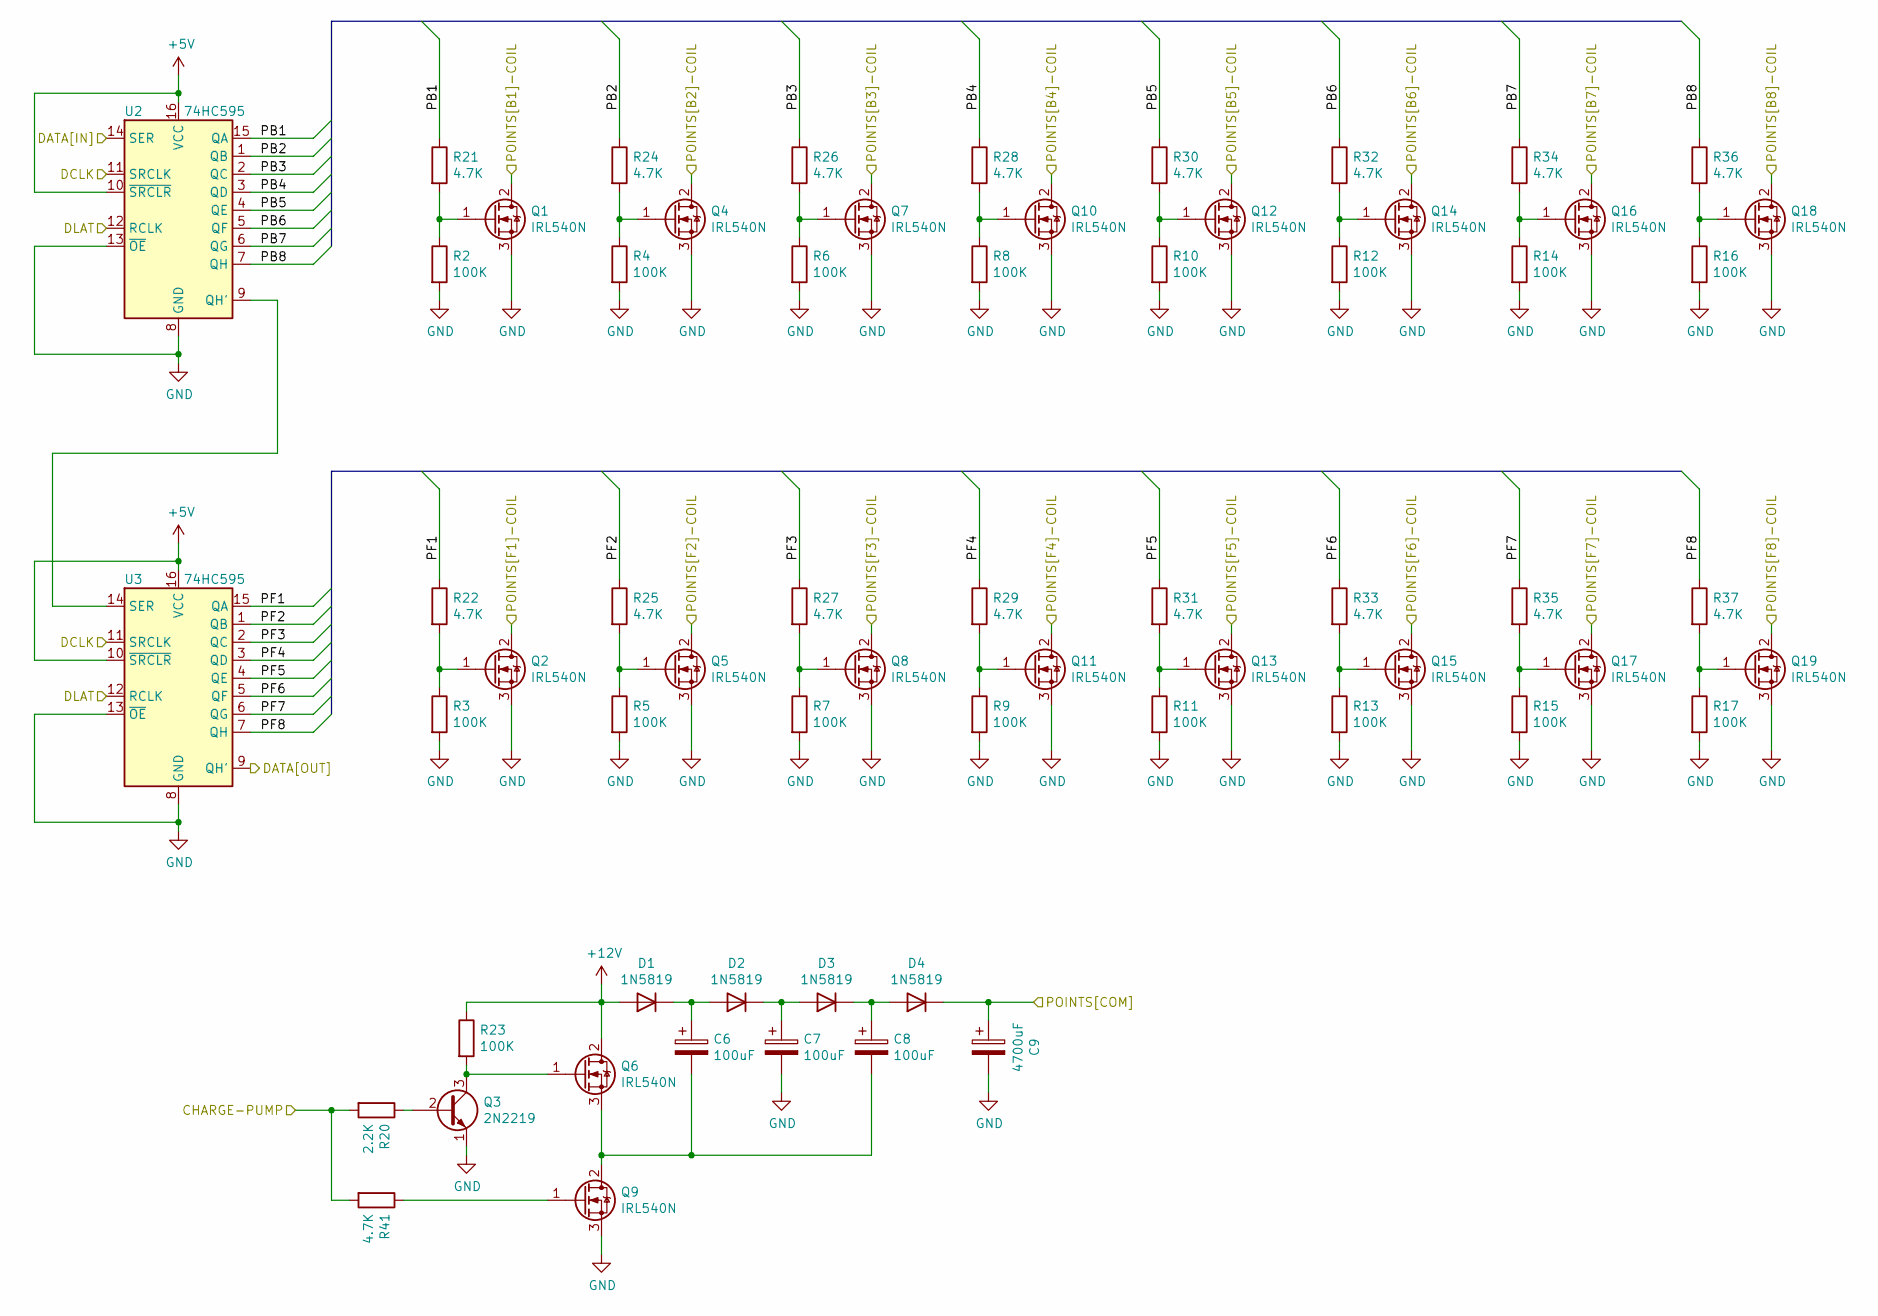
[picture p52: schematic points-control.sch]

Parts:
C6, C7, C8: 100uF; CP_Radial_D8.0mm_P2.50mm
C9: 4700uF; CP_Radial_D18.0mm_P7.50mm
D1, D2, D3, D4: 1N5819; D_DO-15_P12.70mm_Horizontal
Q1, Q2, Q4, Q5, Q6, Q7, Q8, Q9, Q10, Q11, Q12, Q13, Q14, Q15, Q16, Q17, Q18, Q19: IRL540N; TO-220-3_Horizontal
Q3: 2N2219; TO-92_Inline_Wide
R2, R3, R4, R5, R6, R7, R8, R9, R10, R11, R12, R13, R14, R15, R16, R17, R23: 100K; R_Axial_DIN0207_L6.3mm_D2.5mm_P10.16mm_Horizontal
R20: 2.2K; R_Axial_DIN0207_L6.3mm_D2.5mm_P10.16mm_Horizontal
R21, R22, R24, R25, R26, R27, R28, R29, R30, R31, R32, R33, R34, R35, R36, R37, R41: 4.7K; R_Axial_DIN0207_L6.3mm_D2.5mm_P10.16mm_Horizontal
U2, U3: 74HC595; DIP-16_W7.62mm_LongPads

Connections:
+5V: U2.10 (~SRCLR), U2.16 (VCC), U3.10 (~SRCLR), U3.16 (VCC); also elsewhere on the board
+12V: D1.2 (A), Q6.2 (D), R23.1; also elsewhere on the board
/Points Control/CHARGE-PUMP: R20.2, R41.2; also elsewhere on the board
/Points Control/DATA[IN]: U2.14 (SER); also elsewhere on the board
/Points Control/DATA[OUT]: U3.9 (QH'); also elsewhere on the board
/Points Control/PB1: R21.1, U2.15 (QA)
/Points Control/PB2: R24.1, U2.1 (QB)
/Points Control/PB3: R26.1, U2.2 (QC)
/Points Control/PB4: R28.1, U2.3 (QD)
/Points Control/PB5: R30.1, U2.4 (QE)
/Points Control/PB6: R32.1, U2.5 (QF)
/Points Control/PB7: R34.1, U2.6 (QG)
/Points Control/PB8: R36.1, U2.7 (QH)
/Points Control/PF1: R22.1, U3.15 (QA)
/Points Control/PF2: R25.1, U3.1 (QB)
/Points Control/PF3: R27.1, U3.2 (QC)
/Points Control/PF4: R29.1, U3.3 (QD)
/Points Control/PF5: R31.1, U3.4 (QE)
/Points Control/PF6: R33.1, U3.5 (QF)
/Points Control/PF7: R35.1, U3.6 (QG)
/Points Control/PF8: R37.1, U3.7 (QH)
/Points Control/POINTS[B1]-COIL: Q1.2 (D); also elsewhere on the board
/Points Control/POINTS[B2]-COIL: Q4.2 (D); also elsewhere on the board
/Points Control/POINTS[B3]-COIL: Q7.2 (D); also elsewhere on the board
/Points Control/POINTS[B4]-COIL: Q10.2 (D); also elsewhere on the board
/Points Control/POINTS[B5]-COIL: Q12.2 (D); also elsewhere on the board
/Points Control/POINTS[B6]-COIL: Q14.2 (D); also elsewhere on the board
/Points Control/POINTS[B7]-COIL: Q16.2 (D); also elsewhere on the board
/Points Control/POINTS[B8]-COIL: Q18.2 (D); also elsewhere on the board
/Points Control/POINTS[COM]: C9.1, D4.1 (K); also elsewhere on the board
/Points Control/POINTS[F1]-COIL: Q2.2 (D); also elsewhere on the board
/Points Control/POINTS[F2]-COIL: Q5.2 (D); also elsewhere on the board
/Points Control/POINTS[F3]-COIL: Q8.2 (D); also elsewhere on the board
/Points Control/POINTS[F4]-COIL: Q11.2 (D); also elsewhere on the board
/Points Control/POINTS[F5]-COIL: Q13.2 (D); also elsewhere on the board
/Points Control/POINTS[F6]-COIL: Q15.2 (D); also elsewhere on the board
/Points Control/POINTS[F7]-COIL: Q17.2 (D); also elsewhere on the board
/Points Control/POINTS[F8]-COIL: Q19.2 (D); also elsewhere on the board
DCLK: U2.11 (SRCLK), U3.11 (SRCLK); also elsewhere on the board
DLAT: U2.12 (RCLK), U3.12 (RCLK); also elsewhere on the board
GND: C7.2, C9.2, Q1.3 (S), Q2.3 (S), Q3.1 (E), Q4.3 (S), Q5.3 (S), Q7.3 (S), Q8.3 (S), Q9.3 (S), Q10.3 (S), Q11.3 (S), Q12.3 (S), Q13.3 (S), Q14.3 (S), Q15.3 (S), Q16.3 (S), Q17.3 (S), Q18.3 (S), Q19.3 (S), R2.2, R3.2, R4.2, R5.2, R6.2, R7.2, R8.2, R9.2, R10.2, R11.2, R12.2, R13.2, R14.2, R15.2, R16.2, R17.2, U2.8 (GND), U2.13 (~OE), U3.8 (GND), U3.13 (~OE); also elsewhere on the board
unnamed: C6.1, D1.1 (K), D2.2 (A)
unnamed: C6.2, C8.2, Q6.3 (S), Q9.2 (D)
unnamed: C7.1, D2.1 (K), D3.2 (A)
unnamed: C8.1, D3.1 (K), D4.2 (A)
unnamed: Q1.1 (G), R2.1, R21.2
unnamed: Q2.1 (G), R3.1, R22.2
unnamed: Q3.2 (B), R20.1
unnamed: Q3.3 (C), Q6.1 (G), R23.2
unnamed: Q4.1 (G), R4.1, R24.2
unnamed: Q5.1 (G), R5.1, R25.2
unnamed: Q7.1 (G), R6.1, R26.2
unnamed: Q8.1 (G), R7.1, R27.2
unnamed: Q9.1 (G), R41.1
unnamed: Q10.1 (G), R8.1, R28.2
unnamed: Q11.1 (G), R9.1, R29.2
unnamed: Q12.1 (G), R10.1, R30.2
unnamed: Q13.1 (G), R11.1, R31.2
unnamed: Q14.1 (G), R12.1, R32.2
unnamed: Q15.1 (G), R13.1, R33.2
unnamed: Q16.1 (G), R14.1, R34.2
unnamed: Q17.1 (G), R15.1, R35.2
unnamed: Q18.1 (G), R16.1, R36.2
unnamed: Q19.1 (G), R17.1, R37.2
unnamed: U2.9 (QH'), U3.14 (SER)

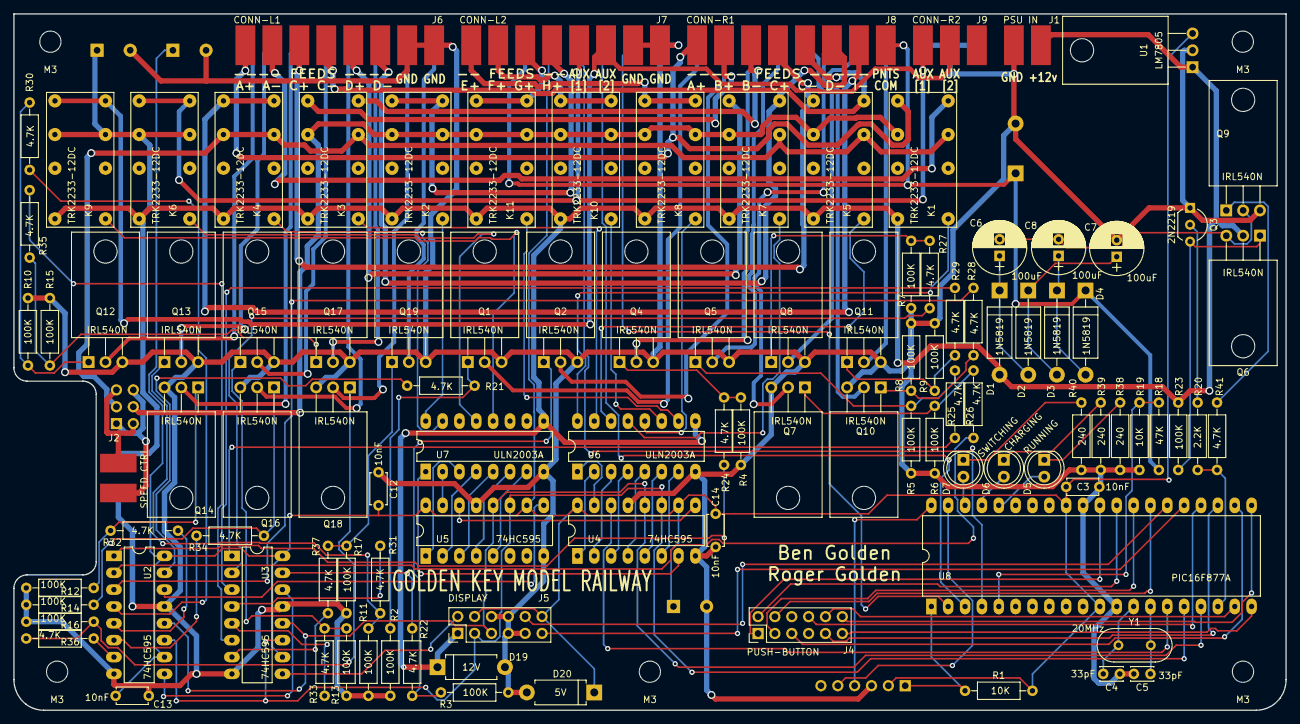
[picture p53: board panel-main.kicad_pcb from above]

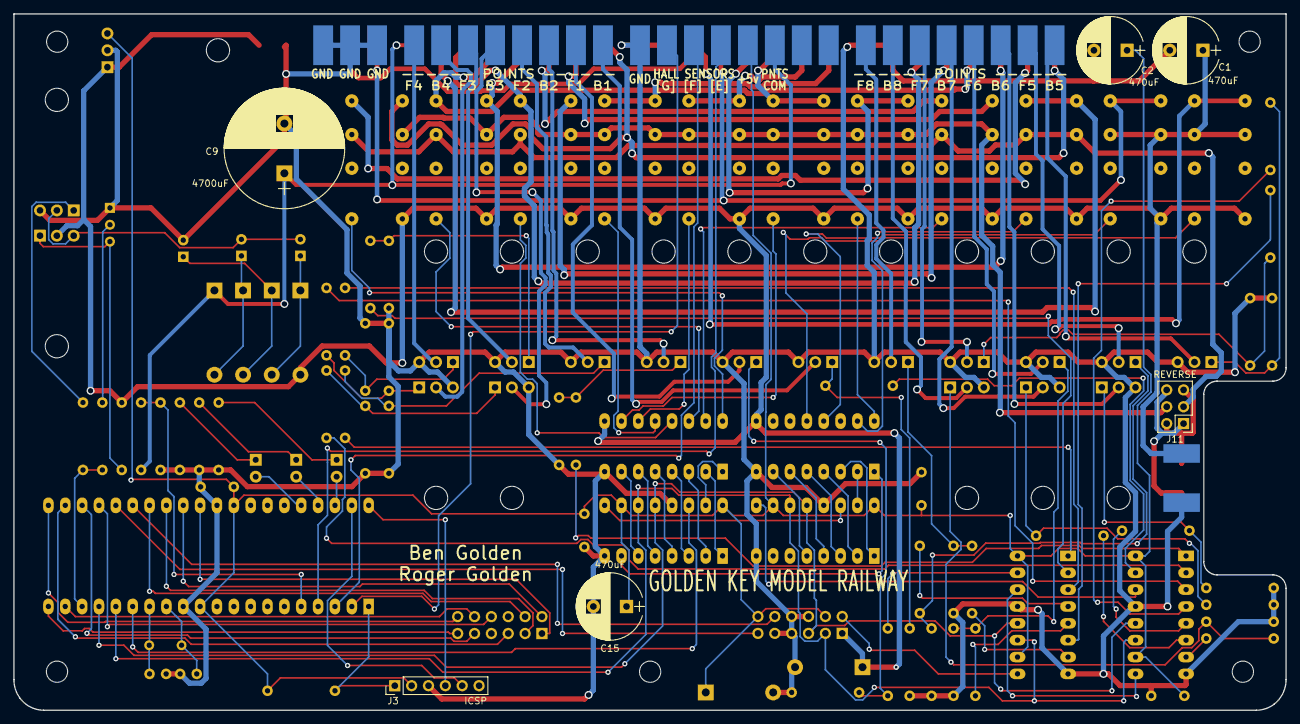
[picture p54: board panel-main.kicad_pcb from below]

Board: 2 copper layers, 191.7 x 104.9 mm, 112 parts (6 on the bottom side), 138 nets.
