CarnivalBen/golden-key/controller/pcb/controller.kicad_pcb

## KiCad design controller/pcb/controller.kicad_pcb (2020-07-15)

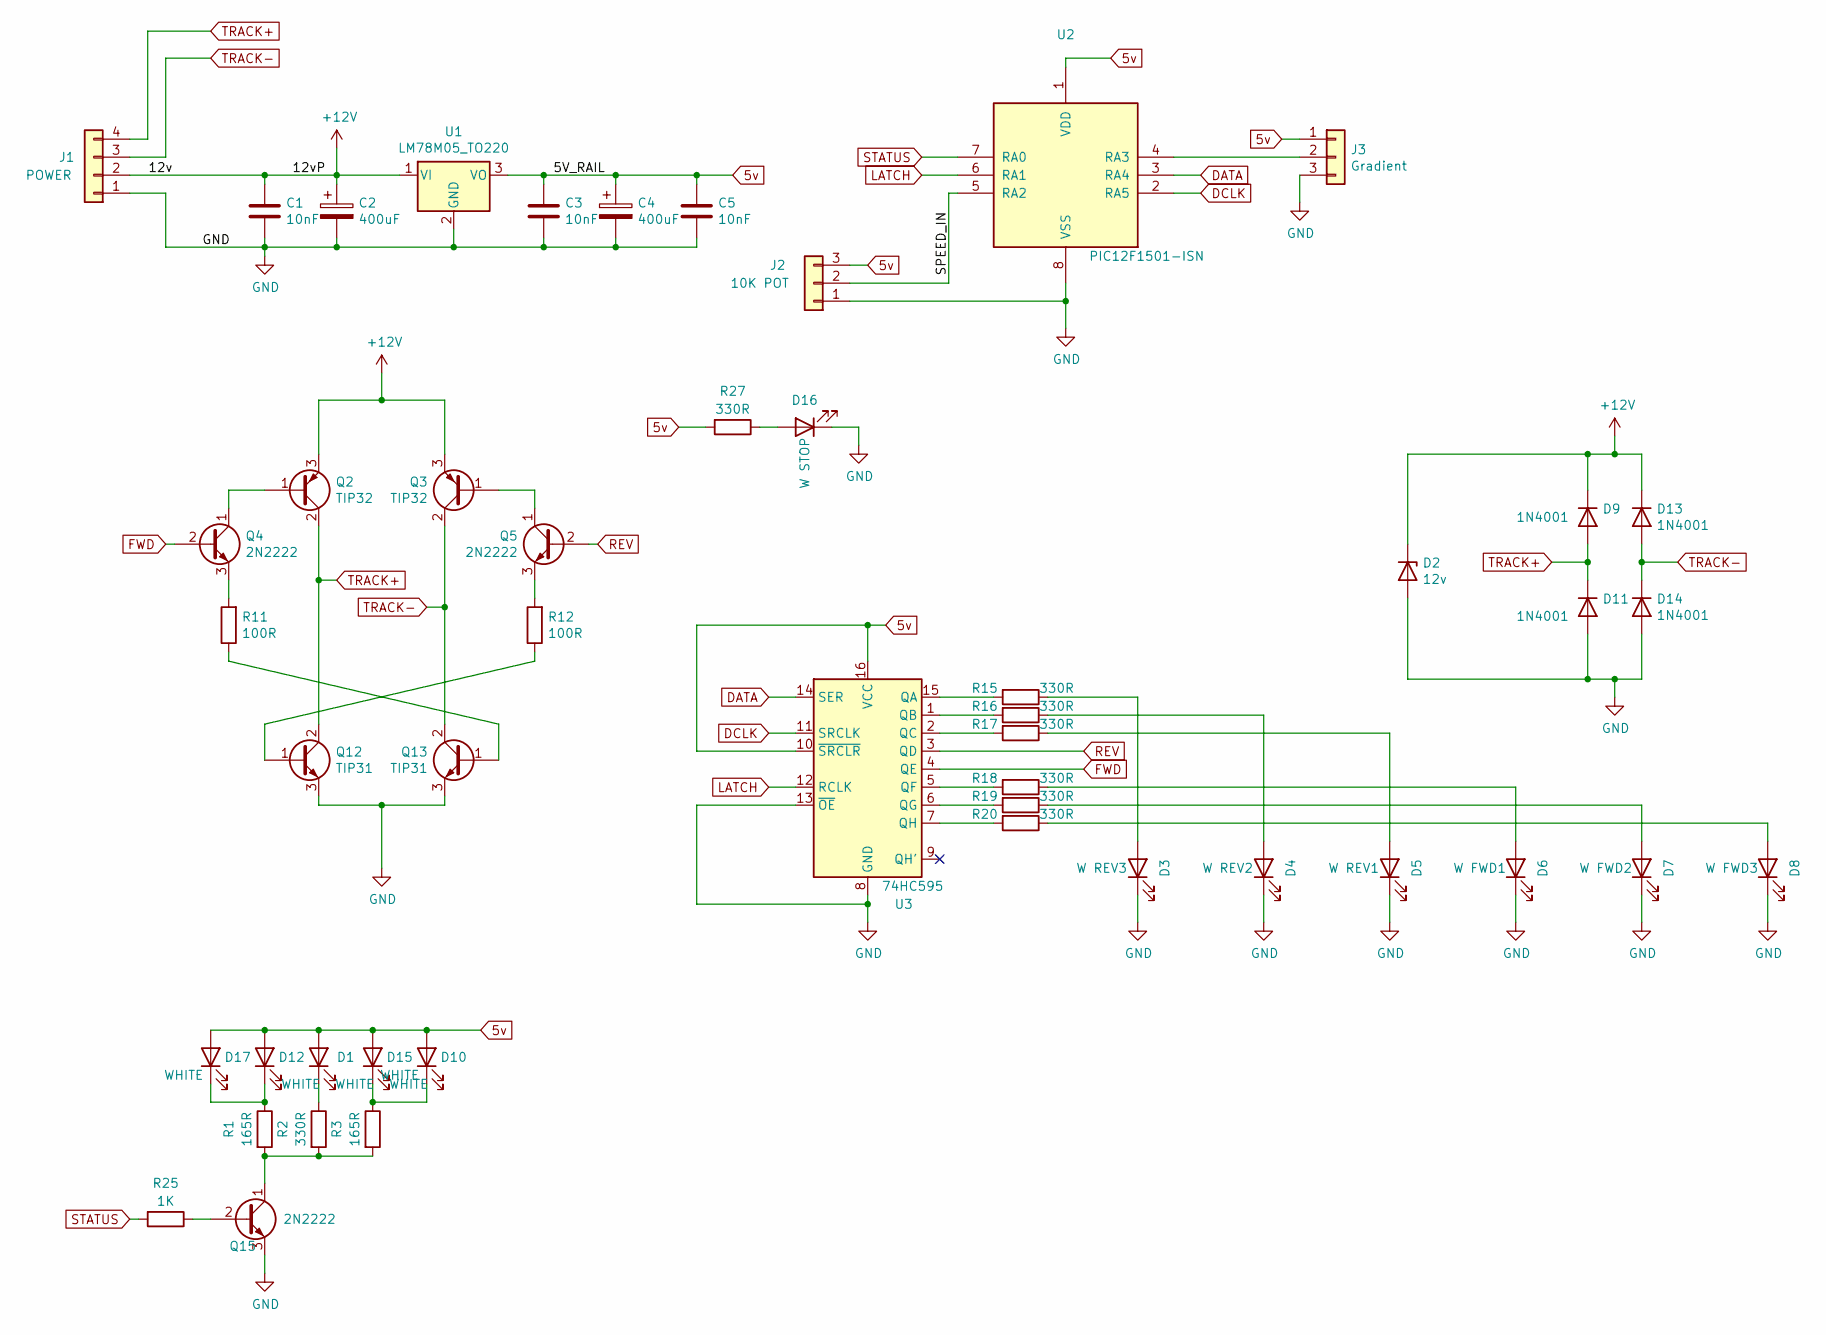
[picture p55: schematic controller.sch]

Parts:
C1, C3, C5: 10nF; C_Disc_D3.0mm_W1.6mm_P2.50mm
C2, C4: 400uF; CP_Radial_D6.3mm_P2.50mm
D1, D10, D12, D15, D17: WHITE; LED_D5.0mm
D2: 12v; D_A-405_P7.62mm_Horizontal
D3: W REV3; LED_D5.0mm
D4: W REV2; LED_D5.0mm
D5: W REV1; LED_D5.0mm
D6: W FWD1; LED_D5.0mm
D7: W FWD2; LED_D5.0mm
D8: W FWD3; LED_D5.0mm
D9, D11, D13, D14: 1N4001; D_A-405_P7.62mm_Horizontal
D16: W STOP; LED_D5.0mm
J1: POWER; Barrier_Terminal_P8.27_1x4
J2: 10K POT; Potentiometer_WirePads_Small
J3: Gradient; Pin_Header_Straight_1x03_Pitch2.54mm
Q2, Q3: TIP32; TO-220-3_Horizontal
Q4, Q5, Q15: 2N2222; TO-92_Inline_Wide
Q12, Q13: TIP31; TO-220-3_Horizontal
R1, R3: 165R; R_Axial_DIN0411_L9.9mm_D3.6mm_P12.70mm_Horizontal
R2, R15, R16, R17, R18, R19, R20, R27: 330R; R_Axial_DIN0411_L9.9mm_D3.6mm_P12.70mm_Horizontal
R11, R12: 100R; R_Axial_DIN0411_L9.9mm_D3.6mm_P12.70mm_Horizontal
R25: 1K; R_Axial_DIN0411_L9.9mm_D3.6mm_P12.70mm_Horizontal
U1: LM78M05_TO220; TO-220-3_Horizontal
U2: PIC12F1501-ISN; DIP-8_W7.62mm_Socket_LongPads
U3: 74HC595; DIP-16_W7.62mm_Socket_LongPads

Connections:
5v: C3.1, C4.1, C5.1, D1.2 (A), D10.2 (A), D12.2 (A), D15.2 (A), D17.2 (A), J2.3, J3.1, R27.2, U1.3 (VO), U2.1 (VDD), U3.10 (~SRCLR), U3.16 (VCC)
+12V: C1.1, C2.1, D2.1 (K), D9.1 (K), D13.1 (K), J1.2, Q2.3 (E), Q3.3 (E), U1.1 (VI)
/SPEED_IN: J2.2, U2.5 (RA2)
DATA: U2.3 (RA4), U3.14 (SER)
DCLK: U2.2 (RA5), U3.11 (SRCLK)
FWD: Q4.2 (B), U3.4 (QE)
GND: C1.2, C2.2, C3.2, C4.2, C5.2, D2.2 (A), D3.1 (K), D4.1 (K), D5.1 (K), D6.1 (K), D7.1 (K), D8.1 (K), D11.2 (A), D14.2 (A), D16.1 (K), J1.1, J2.1, J3.3, Q12.3 (E), Q13.3 (E), Q15.3 (E), U1.2 (GND), U2.8 (VSS), U3.8 (GND), U3.13 (~OE)
LATCH: U2.6 (RA1), U3.12 (RCLK)
unnamed: D1.1 (K), R2.1
unnamed: D3.2 (A), R15.1
unnamed: D4.2 (A), R16.1
unnamed: D5.2 (A), R17.1
unnamed: D6.2 (A), R18.1
unnamed: D7.2 (A), R19.1
unnamed: D8.2 (A), R20.1
unnamed: D10.1 (K), D15.1 (K), R3.1
unnamed: D12.1 (K), D17.1 (K), R1.1
unnamed: D16.2 (A), R27.1
unnamed: J3.2, U2.4 (RA3)
unnamed: Q2.1 (B), Q4.1 (C)
unnamed: Q3.1 (B), Q5.1 (C)
unnamed: Q4.3 (E), R11.2
unnamed: Q5.3 (E), R12.2
unnamed: Q12.1 (B), R12.1
unnamed: Q13.1 (B), R11.1
unnamed: Q15.1 (C), R1.2, R2.2, R3.2
unnamed: Q15.2 (B), R25.1
unnamed: R15.2, U3.15 (QA)
unnamed: R16.2, U3.1 (QB)
unnamed: R17.2, U3.2 (QC)
unnamed: R18.2, U3.5 (QF)
unnamed: R19.2, U3.6 (QG)
unnamed: R20.2, U3.7 (QH)
REV: Q5.2 (B), U3.3 (QD)
STATUS: R25.2, U2.7 (RA0)
TRACK+: D9.2 (A), D11.1 (K), J1.4, Q2.2 (C), Q12.2 (C)
TRACK-: D13.2 (A), D14.1 (K), J1.3, Q3.2 (C), Q13.2 (C)
