CarnivalBen/golden-key/controller/pcb/controller.kicad_pcb

## KiCad design controller/pcb/controller.kicad_pcb (continued)

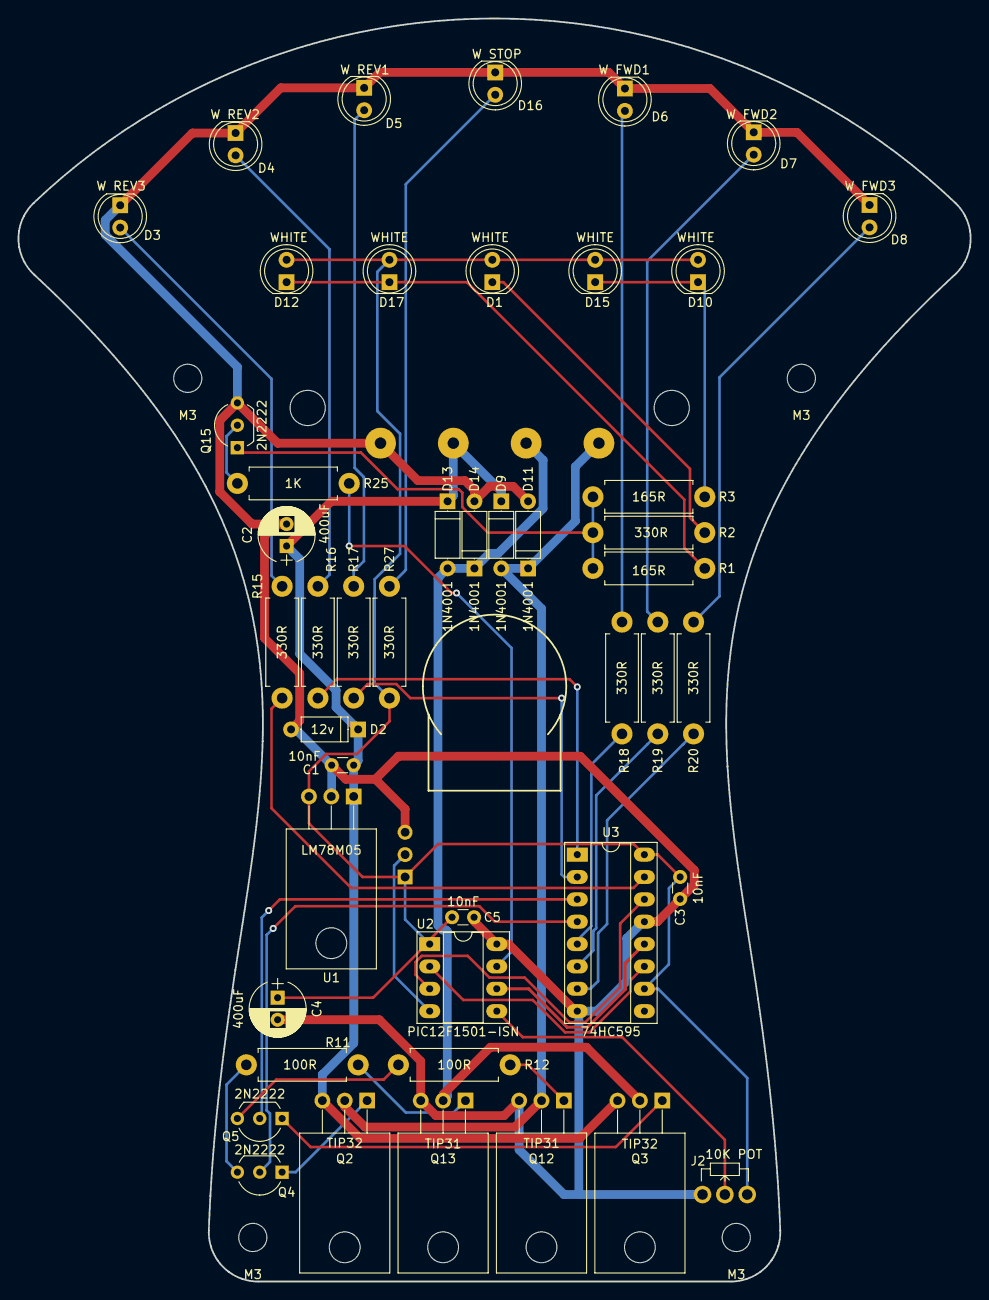
[picture p56: board controller.kicad_pcb from above]

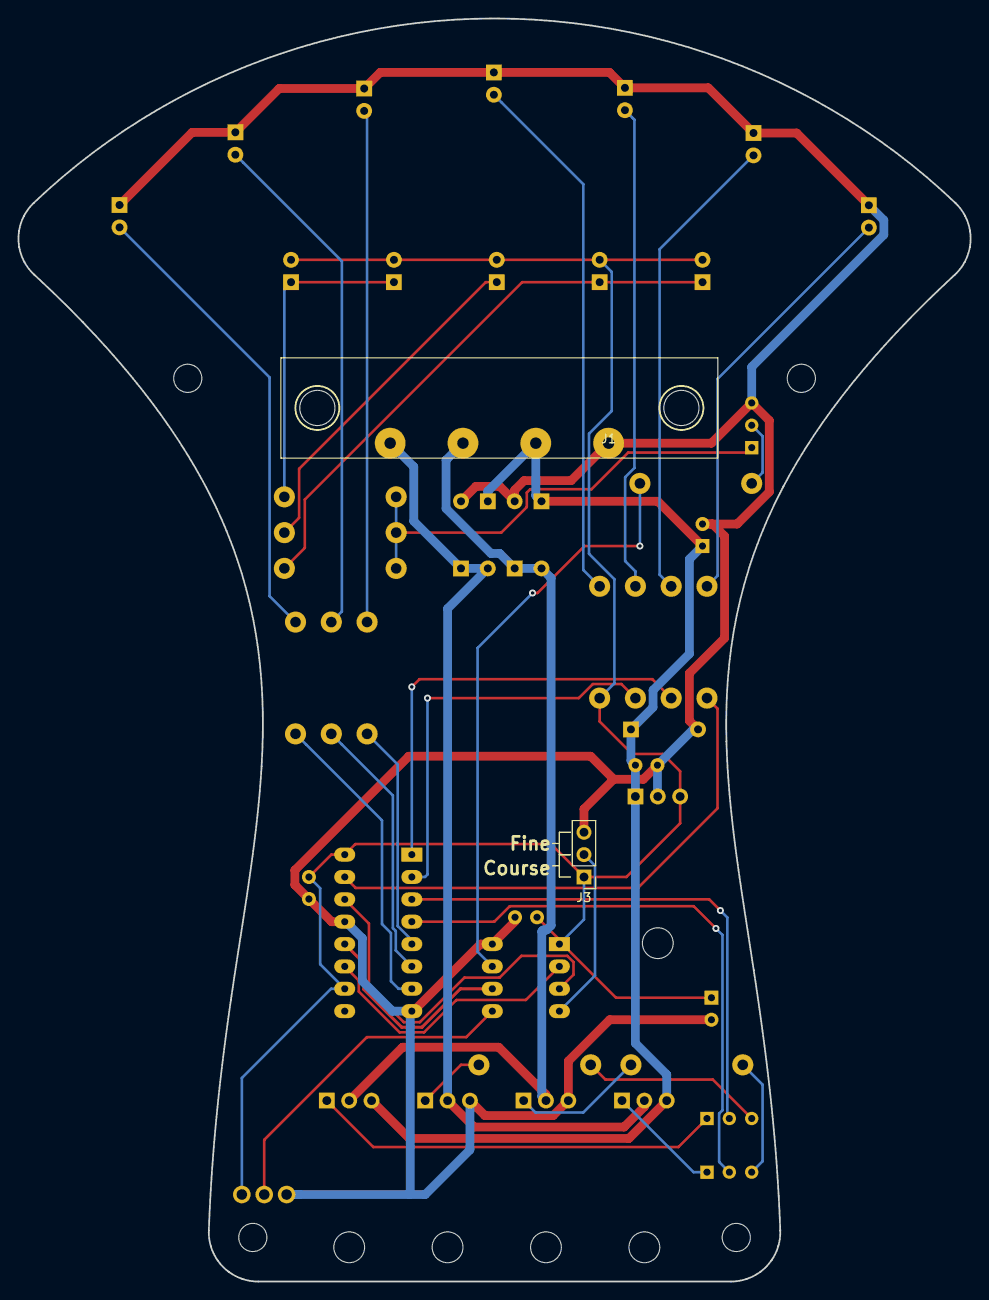
[picture p57: board controller.kicad_pcb from below]

Board: 2 copper layers, 108.1 x 143.5 mm, 48 parts (2 on the bottom side), 37 nets.
