CarnivalBen/golden-key/panel/pcb-main/panel-main - Copy.kicad_pcb

## KiCad design panel/pcb-main/panel-main - Copy.kicad_pcb (2020-07-18, an earlier design)

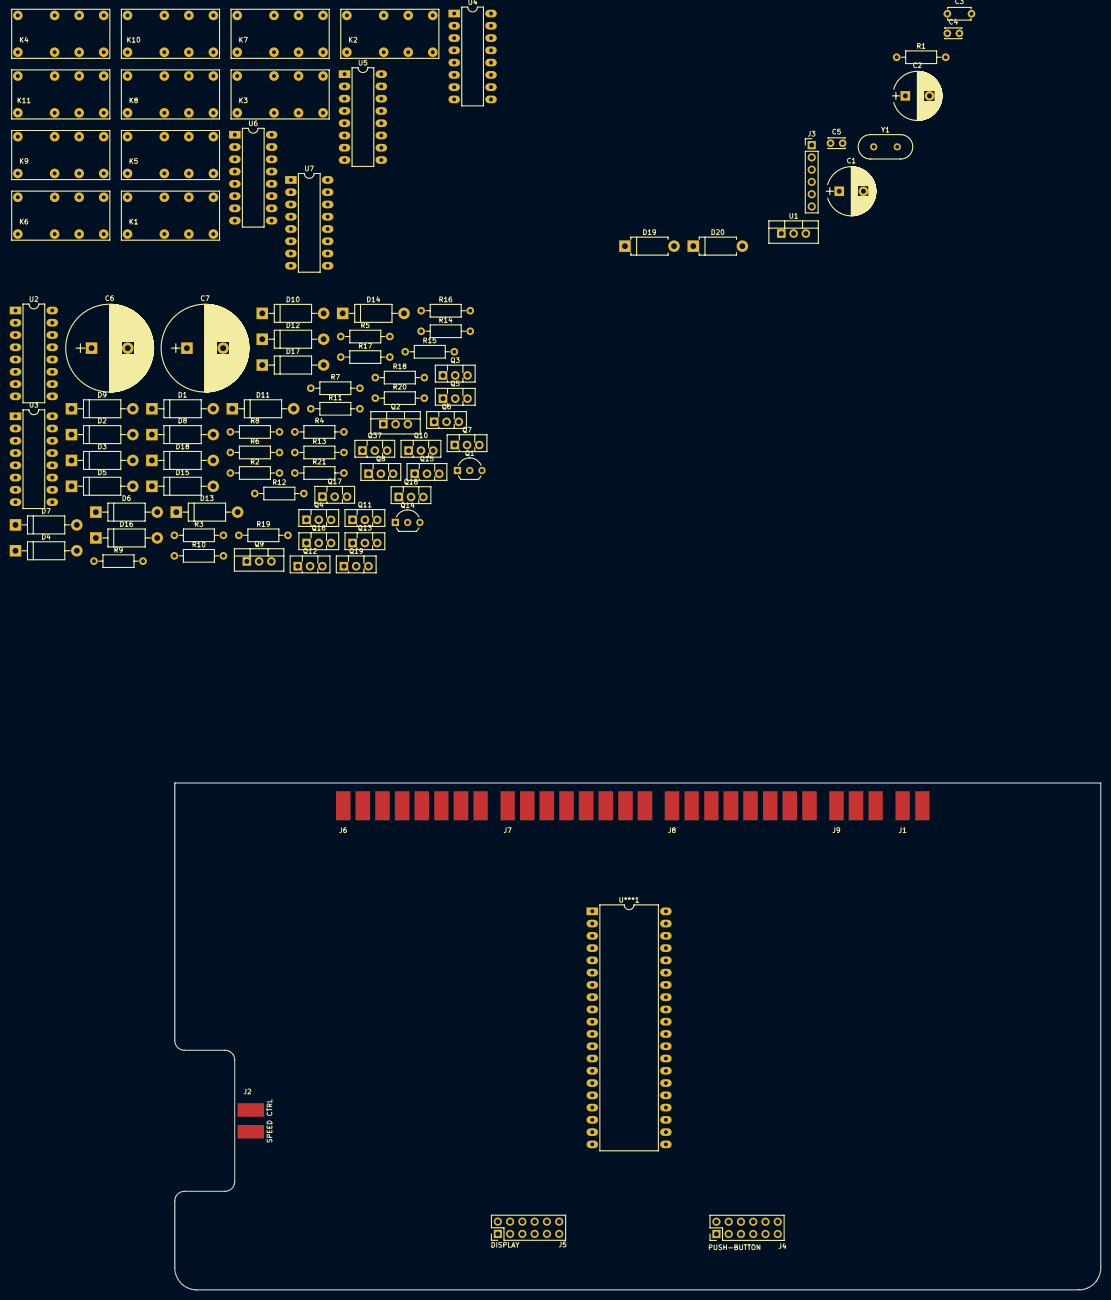
[picture p58: board panel-main - Copy.kicad_pcb from above]

Board: 2 copper layers, 191.7 x 104.9 mm, 97 parts (0 on the bottom side), 131 nets, no tracks yet.

Parts:
C1, C2: 470uF; CP_Radial_D10.0mm_P5.00mm
C3: 10nF; C_Disc_D4.7mm_W2.5mm_P5.00mm
C4, C5: 33pF; C_Disc_D3.4mm_W2.1mm_P2.50mm
C6, C7: 4700uF; CP_Radial_D18.0mm_P7.50mm
D1, D2, D3, D4, D5, D6, D7, D8, D9, D10, D11, D12, D13, D14, D15, D16, D17, D18: 1N4001; D_DO-15_P12.70mm_Horizontal
D19: 12V; D_DO-15_P10.16mm_Horizontal
D20: 5V; D_DO-15_P10.16mm_Horizontal
J1: PSU IN; Wire_Pads_Edge_1x2
J2: SPEED CTRL; DIN_Socket_Edge_Solder_4pin
J3: ICSP; Pin_Header_Straight_1x06_Pitch2.54mm
J4: PUSH-BUTTON; Pin_Header_Straight_2x06_Pitch2.54mm
J5: DISPLAY; Pin_Header_Straight_2x06_Pitch2.54mm
J6: CONN-L1; Wire_Pads_Edge_2x8
J7: CONN-L2; Wire_Pads_Edge_2x8
J8: CONN-R1; Wire_Pads_Edge_2x8
J9: CONN-R2; Wire_Pads_Edge_2x3
K1, K2, K3, K4, K5, K6, K7, K8, K9, K10, K11: TRK2233-12DC; TRK22X3-XXDC
Q1, Q14: 2N2222; TO-92_Inline_Wide
Q2, Q9: TIP32; TO-220-3_Vertical
Q3, Q4, Q5, Q6, Q7, Q8, Q10, Q11, Q12, Q13, Q15, Q16, Q17, Q18, Q19, Q37: BD679; TO-126_Vertical
R1: 10K; R_Axial_DIN0207_L6.3mm_D2.5mm_P10.16mm_Horizontal
R2, R3, R8, R9: 5K; R_Axial_DIN0207_L6.3mm_D2.5mm_P10.16mm_Horizontal
R4, R5, R6, R7, R10, R11, R12, R13, R14, R15, R16, R17, R18, R19, R20, R21: 1K; R_Axial_DIN0207_L6.3mm_D2.5mm_P10.16mm_Horizontal
U1: LM7805_TO220; TO-220-3_Vertical
U2, U3, U4, U5: 74HC595; DIP-16_W7.62mm_LongPads
U6, U7: ULN2003A; DIP-16_W7.62mm_LongPads
U***1: PIC16F877A; DIP-40_W15.24mm_LongPads
Y1: 20MHz; Crystal_HC49-U_Vertical

Connections:
+5V: C2.1, C3.1, D20.1, J3.2, J5.4, J5.12, J7.13, R1.2, U1.3, U2.10, U2.16, U3.10, U3.16, U4.10, U4.16, U5.10, U5.16, U***1.11, U***1.32
+12V: C1.1, D1.2, D4.2, D19.1, J1.2, J2.4, J5.1, K1.1, K2.1, K3.1, K4.1, K5.1, K6.1, K6.3, K6.6, K7.1, K8.1, K9.1, K9.3, K9.6, K10.1, K11.1, U1.1, U6.9, U7.9
/AUX1-LED: J5.11, U***1.25
/AUX2-LED: J5.10, U***1.26
/Feed Relays/AUX[1]: J7.5, J9.1, K6.4, K6.5
/Feed Relays/AUX[2]: J7.6, J9.2, K9.4, K9.5
/Feed Relays/DATA[IN]: U4.14, U***1.15
/Feed Relays/FEED[A+]: J6.1, J8.1, K1.4
/Feed Relays/FEED[A-]: J6.2, K1.5
/Feed Relays/FEED[B+]: J8.2, K3.4
/Feed Relays/FEED[B-]: J8.3, K3.5
/Feed Relays/FEED[C+]: J6.3, J8.4, K5.4
/Feed Relays/FEED[C-]: J6.4, J8.5, K5.5
/Feed Relays/FEED[D+]: J6.5, K7.4
/Feed Relays/FEED[D-]: J6.6, J8.6, K7.5
/Feed Relays/FEED[E+]: J7.1, K8.4, K8.5
/Feed Relays/FEED[F+]: J7.2, K10.4, K10.5
/Feed Relays/FEED[G+]: J7.3, K11.4, K11.5
/Feed Relays/FEED[H+]: J7.4, K2.4, K2.5
/Feed Relays/FEED[I-]: J8.7, K4.4, K4.5
/HALL[E]: J7.12, U***1.4
/HALL[F]: J7.11, U***1.3
/HALL[G]: J7.10, U***1.2
/PB1: J4.1, U***1.30
/PB2: J4.2, U***1.29
/PB3: J4.3, U***1.28
/PB4: J4.4, U***1.27
/PB5: J4.5, U***1.22
/PB6: J4.12, U***1.21
/PB7: J4.11, U***1.20
/PB8: J4.10, U***1.19
/PB9: J4.9, U***1.8
/PB10: J4.8, U***1.9
/Points Control/DATA[IN]: U2.14, U5.9
/Points Control/DATA[OUT]: J5.2, U3.9
/Points Control/PB1: R4.1, U2.15
/Points Control/PB2: R6.1, U2.1
/Points Control/PB3: R10.1, U2.2
/Points Control/PB4: R12.1, U2.3
/Points Control/PB5: R14.1, U2.4
/Points Control/PB6: R16.1, U2.5
/Points Control/PB7: R18.1, U2.6
/Points Control/PB8: R20.1, U2.7
/Points Control/PF1: R5.1, U3.15
/Points Control/PF2: R7.1, U3.1
/Points Control/PF3: R11.1, U3.2
/Points Control/PF4: R13.1, U3.3
/Points Control/PF5: R15.1, U3.4
/Points Control/PF6: R17.1, U3.5
/Points Control/PF7: R19.1, U3.6
/Points Control/PF8: R21.1, U3.7
/Points Control/POINTS[B1]-COIL: D2.1, J8.16, Q37.3
/Points Control/POINTS[B2]-COIL: D5.1, J8.14, Q4.3
/Points Control/POINTS[B3]-COIL: D7.1, J8.12, Q6.3
/Points Control/POINTS[B4]-COIL: D9.1, J8.10, Q8.3
/Points Control/POINTS[B5]-COIL: D11.1, J6.16, Q11.3
/Points Control/POINTS[B6]-COIL: D13.1, J6.14, Q13.3
/Points Control/POINTS[B7]-COIL: D15.1, J6.12, Q16.3
/Points Control/POINTS[B8]-COIL: D17.1, J6.10, Q18.3
/Points Control/POINTS[F1]-COIL: D3.1, J8.15, Q3.3
/Points Control/POINTS[F2]-COIL: D6.1, J8.13, Q5.3
/Points Control/POINTS[F3]-COIL: D8.1, J8.11, Q7.3
/Points Control/POINTS[F4]-COIL: D10.1, J8.9, Q10.3
/Points Control/POINTS[F5]-COIL: D12.1, J6.15, Q12.3
/Points Control/POINTS[F6]-COIL: D14.1, J6.13, Q15.3
/Points Control/POINTS[F7]-COIL: D16.1, J6.11, Q17.3
/Points Control/POINTS[F8]-COIL: D18.1, J6.9, Q19.3
/Points Control/TANK[1]: R2.2, U***1.33
/Points Control/TANK[2]: R9.2, U***1.34
DCLK: J5.3, U2.11, U3.11, U4.11, U5.11, U***1.16
DLAT: J5.5, U2.12, U3.12, U4.12, U5.12, U***1.17
GND: C1.2, C2.2, C3.2, C4.2, C5.2, C6.2, C7.2, D2.2, D3.2, D5.2, D6.2, D7.2, D8.2, D9.2, D10.2, D11.2, D12.2, D13.2, D14.2, D15.2, D16.2, D17.2, D18.2, D19.2, D20.2, J1.1, J2.1, J3.3, J5.8, J6.7, J6.8, J7.7, J7.8, J7.9, J9.4, J9.5, J9.6, Q1.3, Q14.3, U1.2, U2.8, U2.13, U3.8, U3.13, U4.8, U4.13, U5.8, U5.13, U6.8, U7.8, U***1.12, U***1.31
ICSPCLK: J3.5, U***1.39
ICSPDAT: J3.4, U***1.40
MCLR: J3.1, R1.1, U***1.1
unnamed: C4.1, U***1.13, Y1.1
unnamed: C5.1, U***1.14, Y1.2
unnamed: C6.1, D1.1, Q2.3
unnamed: C7.1, D4.1, Q9.3
unnamed: K1.8, U6.16
unnamed: K2.8, U7.16
unnamed: K3.8, U6.15
unnamed: K4.8, U7.15
unnamed: K5.8, U6.14
unnamed: K6.8, U7.13
unnamed: K7.8, U6.13
unnamed: K8.8, U6.12
unnamed: K9.8, U7.12
unnamed: K10.8, U6.11
unnamed: K11.8, U6.10
unnamed: Q1.1, R3.1
unnamed: Q1.2, R2.1
unnamed: Q2.1, R3.2
unnamed: Q3.1, R5.2
unnamed: Q4.1, R6.2
unnamed: Q5.1, R7.2
unnamed: Q6.1, R10.2
unnamed: Q7.1, R11.2
unnamed: Q8.1, R12.2
unnamed: Q9.1, R8.2
unnamed: Q10.1, R13.2
unnamed: Q11.1, R14.2
unnamed: Q12.1, R15.2
unnamed: Q13.1, R16.2
unnamed: Q14.1, R8.1
unnamed: Q14.2, R9.1
unnamed: Q15.1, R17.2
unnamed: Q16.1, R18.2
unnamed: Q17.1, R19.2
unnamed: Q18.1, R20.2
unnamed: Q19.1, R21.2
unnamed: Q37.1, R4.2
unnamed: U2.9, U3.14
unnamed: U4.1, U6.2
unnamed: U4.2, U6.3
unnamed: U4.3, U6.4
unnamed: U4.4, U6.5
unnamed: U4.5, U6.6
unnamed: U4.6, U6.7
unnamed: U4.7, U7.1
unnamed: U4.9, U5.14
unnamed: U4.15, U6.1
unnamed: U5.1, U7.3
unnamed: U5.2, U7.4
unnamed: U5.3, U7.5
unnamed: U5.4, U7.6
unnamed: U5.5, U7.7
unnamed: U5.15, U7.2
TANK-DUMP: Q2.2, Q3.2, Q4.2, Q5.2, Q6.2, Q7.2, Q8.2, Q9.2, Q10.2, Q11.2, Q12.2, Q13.2, Q15.2, Q16.2, Q17.2, Q18.2, Q19.2, Q37.2
TRACK+: J2.3, K1.3, K2.3, K2.6, K3.3, K5.3, K7.3, K8.3, K8.6, K10.3, K10.6, K11.3, K11.6
TRACK-: J2.2, K1.6, K3.6, K4.3, K4.6, K5.6, K7.6
