CarnivalBen/golden-key/controller/firmware/main.c

// CONFIG1
#pragma config FOSC = INTOSC    //  (INTOSC oscillator; I/O function on CLKIN pin)
#pragma config WDTE = OFF        // Watchdog Timer Enable (WDT enabled)
#pragma config PWRTE = OFF      // Power-up Timer Enable (PWRT disabled)
#pragma config MCLRE = OFF      // MCLR Pin Function Select (MCLR/VPP pin function is digital input)
#pragma config CP = OFF         // Flash Program Memory Code Protection (Program memory code protection is disabled)
#pragma config BOREN = ON       // Brown-out Reset Enable (Brown-out Reset enabled)
#pragma config CLKOUTEN = OFF   // Clock Out Enable (CLKOUT function is disabled. I/O or oscillator function on the CLKOUT pin)

// CONFIG2
#pragma config WRT = OFF        // Flash Memory Self-Write Protection (Write protection off)
#pragma config PLLEN = ON       // PLL Enable (4x PLL enabled)
#pragma config STVREN = ON      // Stack Overflow/Underflow Reset Enable (Stack Overflow or Underflow will cause a Reset)
#pragma config BORV = LO        // Brown-out Reset Voltage Selection (Brown-out Reset Voltage (Vbor), low trip point selected.)
#pragma config LPBOREN = OFF    // Low Power Brown-out Reset enable bit (LPBOR is disabled)
#pragma config LVP = OFF         // Low-Voltage Programming Enable (Low-voltage programming enabled)

#include <xc.h>
#include <stdio.h>
#include <stdlib.h>
#include "main.h"

volatile union {
    struct {
        unsigned F3 : 1;
        unsigned F2 : 1;
        unsigned F1 : 1;
        unsigned FWD : 1;
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
        pwmCount--;
        
        if (phase == 0 && pwmCount == 0) {
            pwmCount = gap;
            phase = 1;

            output.FWD = 0;
            output.REV = 0;            

        } else if (phase == 1 && pwmCount == 0) {
            pwmCount = pulse;
            phase = 0;

            if (trainDirection) {
                output.REV = 0;
                output.FWD = 1;
            } else {
                output.FWD = 0;
                output.REV = 1;
            }       
                     
        }     
    //}     
               
}


void updateSpeed() {
    
    byte thresMid = 85; //91;
    byte thresTop = 170; //323;

    ADCON1 = 0b01100000;
    ADCON0 = 0b00001011;
    
    while (ADCON0bits.GO_nDONE);
    
    trainDirection = (ADRESH & 0x80) >> 7;    
    byte speed = (ADRES >> 7);        
    
    if (!trainDirection) speed = 255 - speed;         
    
    if (!RA3) {
        speed = speed / 3;
        thresMid = 85 / 3;
        thresTop = 170 / 3;
    }
    
    pulse = (word)speedPulse[speed >> 1];    
    gap = speedGap[speed >> 1];
    
    
    if (pulse == 0 && TMR0IE == 1) {
        TMR0IE = 0;
        output.FWD = 0;
        output.REV = 0;
        
    } else if (pulse != 0 && TMR0IE == 0) {
        pwmCount = pulse;
        phase = 0;
        TMR0IE = 1;
    }
               
    if (!trainDirection) {        
        output.R3 = 0;
        output.R2 = 0;
        output.R1 = 0;
        output.F1 = pulse > 0;
        output.F2 = pulse > 0 && speed > thresMid;
        output.F3 = pulse > 0 && speed > thresTop; 
        
    } else {
        output.F3 = 0;
        output.F2 = 0;
        output.F1 = 0;
        output.R1 = pulse > 0;
        output.R2 = pulse > 0 && speed > thresMid;
        output.R3 = pulse > 0 && speed > thresTop; 
        
    }    
}




void setShiftReg() {
    
    byte buff = output.shiftData;
    byte mask = 0b10000000;

    do {
        
        if (buff & mask) {
            LATA4 = 1;
        } else {
            LATA4 = 0;
        }
        
        NOP();
        LATA5 = 1;
        NOP();        
        LATA5 = 0;        
        
        mask = mask >> 1;
    } while (mask > 0);
    
    LATA1 = 1;
    NOP();
    LATA1 = 0;
    LATA4 = 0;
    LATA5 = 0;
    
}
