CarnivalBen/golden-key/controller/firmware/main.h

/* 
 * File:   main.h
 * Author: ben.golden
 *
 * Created on 25 June 2020, 18:37
 */

#ifndef MAIN_H
#define	MAIN_H

#ifdef	__cplusplus
extern "C" {
#endif


typedef unsigned char byte;
typedef unsigned int word;



void setShiftReg(void);
void updateSpeed(void);



#ifdef	__cplusplus
}
#endif

#endif	/* MAIN_H */
