CarnivalBen/golden-key/(commit log)

2020-06-28 Added .gitignore. Further work on controller firmware.
    [LED Count.xlsx, Track Speed Adjust Graph.xlsx, controller.sch]
2020-06-28 Further firmware tweaks.
    [controller.sch]
2020-06-30 Controller firmware updated speed curves. Tweaked controller schematic.
    [Track Speed Adjust Graph 2.xlsx]
2020-06-30 Fixed controller firmware gap lookups.
    [main.c]
2020-06-30 Fixed LED speed indicator bug that was lighting LEDs 2 and 3 in dead zone
    [main.c]
2020-07-09 Switched overload to ADC in firmware.
2020-07-15 Added gradient control to PCB.
    [controller.kicad_pcb, controller.sch]
2020-07-18 PCB Updates and added panel-fw project.
    [feed-relays.sch, layout-diag.kicad_pcb, led-track.sch, panel-main - Copy.kicad_pcb, panel-main.sch, points-control.sch]
2020-08-10 Main PCB Update - MOSFETS on Points, 3 tanks.
    [Points Actions.xlsx, panel-main.kicad_pcb, panel-main.sch, points-control.sch]
2020-08-14 Completed all PCBs and added gerber files
    [controller-B_Cu.gbr, controller-B_Mask.gbr, controller-B_SilkS.gbr, controller-Edge_Cuts.gbr, controller-F_Cu.gbr, controller-F_Mask.gbr, controller-F_SilkS.gbr, controller.drl]
2020-08-16 Panel firmware button testing
2020-08-16 Panel firmware - coded button push logic
2020-08-19 Fixed charge pump
2020-08-20 panel firmware bug fixes
    [main.c]
2020-08-21 Changed EEPROM read/write method
    [controller-lid.stl, controller-main-body.stl, controller-middler-testpiece.stl, controller-middler.stl, controller-thick-middler.stl, controller-windows.stl, magnet-mount.stl, panel-case.stl]
2020-08-26 Fixed points mosfet bug
    [main.c, main.h]
2020-08-28 Added .STLs
    [TO-220-pad.stl, button.stl, cable-tie-18.stl, cable-tie-20.stl, cable-tie.stl, panel-base.stl, panel-display.kicad_pcb, sensor-mount.stl]
2020-08-28 Switched controller pulse graph to /128
    [Track Speed Adjust Graph 2.xlsx]
